buchtawill/TeslaCoilController/midi_files/README.md

IMPORTANT MIDI NOTES

The controller does not support midi events other than note on and note off. Delete all other events at the beginning of a file,
for example, "Text" or "Program change"

Tesla quad plan:

 - Imperial March
 - Spooky scary skeletons
 - Mii Channel - has 2nd part
 - Koopa Kid castle
 - tmbg famous polka
 - Hall of the mountain king
 - Star wars
 - Cantina theme
 - Daggerfall theme 008
 - ~Beach theme mario 

 - maybe virus
 - Minion march

Show order:
    Dual: Star wars opening
    Dual: Zombie nation
    Dual: Cantina
    Single Big: Yakety Sax
    Single Small: Famous Polka
    2 min pause
    Dual: Smash bros
    Dual: Mario Underground
    Dual: Mii channel (2nd part)
    3 min pause
    Dual: Spooky Scary
    1 min pause
    Dual: Imperial march
    1 min pause
    Single Big: All star
    Single Small: Tetris
    Single big: Entertainer
    3-4 min pause
    Dual Dueling Banjos
    2 min pause
    Dual Sweet home alabama, whole thing

MIDI File requirements:
 - Only on and off events - no program control change or tempo change
 - Maximum of 4 notes at any given time
 - Generally, 1 note per track
 - track 0 and 1 correspond to coil A, track 2 and 3 correspond to coil B
 - Track 0 and track 2 can have 2 notes each, as long as there are no notes on tracks 1 and 3.
 + i.e. If track 0 is playing 2 notes, one of the notes will be automatically bumped down to track 1 by software
 - Maximum frequency: Try to stay at C6 or below
 - No notes inside notes: I.E. if a note is playing on track 0, the same note cannot start again before it finishes

 Needs fixing:
 - underworld
 - dual smbtheme
 - south park theme

10/28/2025
-----------------------
Working dual coil songs:
 - zombie nation
 - Sweet home alabame
 - Star wars
 - South park
 - Smbtheme
 - Smash bros
 - Koopa kid fortress
 - nsmbw_world3
 - mario underground
 - minion march
 - mii channel
 - Dance of sugar plum fairy
 - Daggerfall theme 008
 - Cantina band
 - mario win
 - Looney
 - Imperial march
 - Dueling banjos 
 - Spooky scary skelletons
 - tetris_2coils
 - overworld 3
 - Ghostbusters 
 - Caramelldansen
 - Auld land syne*
 - all i want 2*
 - warioware
 - Rush e

Working single coil songs
-----------------------
 - star wars
 - yakety sax
 - 

Faulty dual coil songs:
 - Star trek

Not broken, needs work
 - Office theme
 - Beethoven virus 3 channels
 - beach theme mario
 - Rush E beginning too high
 - nsmbwiiKoopaKidCastle -> OK but start is iffy

Spooky Sparks 10/29/2025 set list
-------------------
220 variac: 300Vdc at 2nd notch after 210

 - DUAL:   star wars opening
 - DUAL:   Cantina band
 -     1 min
 - DUAL:   imperial march
 -     1 min
 - SINGLE: big - hall of mountain king (not onetesla)
 - SINGLE: small - all star
 - DUAL:   rush e
 - DUAL:   warioware
 -     2 min 
 - DUAL:   skeletons
 -     1 min
 - SINGLE: big - tmbg famous polka
 -     2 min
 - DUAL:   Mii channel
 - DUAL:   Dance - only first part
 - DUAL:   all i want for christmas
 -     1 min
 - DUAL:   Dueling banjos
 -     2 min 
 - DUAL:   Sweet home alabama

### starting test run at 2:30
### Ended at 2:55 with above set list
