buchtawill/TeslaCoilController/temp_volt_amp_board/firmware/display_board/README.txt

Start by getting GPIO working on !OE pin

Get SPI working to display simple stuff

Code running with multiple SPI 

Add PWM to OE pin

Add ADC acquisition
