buchtawill/TeslaCoilController/Rev2_F401RE/eagle/revb_BOM_assembly.xlsx

Value / PN | Qty | Designator | Package | Description | JLC Part No | MFR Part No
4k7 | 17 | R114, R116, R117, R121, R124, R127, R133, R135, R140, R143, R148, R200, R202, R204, R205, R207, R208 | 0603 | RESISTOR | C99782
100n | 16 | C103, C202, C203, C206, C207, C208, C213, C214, C215, C220, C222, C224, C226, C229, C230, C231 | 0603 | CAPACITOR | C1590
2k2 | 14 | R115, R128, R130, R132, R134, R136, R138, R139, R142, R144, R151, R146, R147, R149, R150 | 0603 | RESISTOR | C113303
MMBT4401(RANGE:100-300) | 10 | T1, T2, T3, T4, T5, T6, T7, T8, T9, T10 | SOT23-BEC | NPN Transistor | C2144
1u | 7 | C201, C204, C221, C223, C225, C227, C228 | 0603 | CAPACITOR | C1592
10u | 8 | C205, C209, C210, C211, C212, C216, C217, C218 | 0805 | CAPACITOR | C15850
LQH3NPN2R2MJRL | 2 | L1, L2 | IND_LQH3NPN2R2MJRL | Inductor | C9890
473521001 | 1 | J2 | SMD | Micro SD Card connector | C293569 | 473521001
STM32F401RE | 1 | IC1 | LQFP64-10X10MM | Microcontroller | C116978
TPS63001 | 1 | IC4 | 10VSON | 3.3V regulator | C28060
TPS63002 | 1 | IC5 | 10VSON | 5V regulator | C116655
