buchtawill/TeslaCoilController/Rev2_F401RE/eagle/revb_BOM.txt

Partlist exported from C:/Users/bucht/OneDrive - Worcester Polytechnic Institute (wpi.edu)/Projects/Interrupter/TeslaCoilController/Rev2_F401RE/eagle/revb.sch at 8/19/2024 11:08 PM

Qty Value               Device                                                               Package                       Parts                                                                                                                                      Description                                                                                   AVAILABILITY CHECK_PRICES                                                                      COPYRIGHT                                                DESCRIPTION                                                       MANUFACTURER                MANUFACTURER_PART_NUMBER MAXIMUM_PACKAGE_HEIGHT MF                 MFR_NAME           MP              MPN               OC_FARNELL OC_NEWARK PACKAGE                     PARTREV POPULARITY PRICE PURCHASE-URL                                                                                                                         SNAPEDA_LINK                                                                       SNAPEDA_PN          SPICEPREFIX STANDARD                     SUPPLIER  VALUE   
1                       10-XX                                                                B3F-10XX                      RST                                                                                                                                        OMRON SWITCH                                                                                                                                                                                                                                                                                                                                                                                                                                              B3F-1000          176432     36M3542                                       72                                                                                                                                                                                                                                                                                                                      
1                       CRYSTALHC49S                                                         HC49/S                        XTAL                                                                                                                                       CRYSTAL                                                                                                                                                                                                                                                                                                                                                                                                                                                                     1667008    unknown                                                                                                                                                                                                                                                                                                                                                               
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
2   LQH3NPN2R2MJRL      LQH3NPN2R2MJRL                                                       IND_LQH3NPN2R2MJRL            L1, L2                                                                                                                                     Inductor Power Chip Shielded Wirewound 33uH 20% 1MHz Ferrite 0.63A 0.948Ohm DCR 1212 T/R                                                                                                                                                                                                                                Murata                                               1.2mm                                                                                                                                           N/A                                                                                                                                                                                                                                                                              Manufacturer Recommendations                   
1   LTV-816S            SMD-PHOTOCOUPLER-5KV-LTV-816S(4P-4.6X6.5MM)                          SMD4-2.54-4.6X6.5MM           U2                                                                                                                                         306060007                                                                                                                                                                                                                                                                                                                                                                                                                                                 LTV-816S                                                                                                                                                                                                                                                                                                                                                                                   LTV-816S
1   MCP73832            MCP73831T-2ACI/OT                                                    SOT95P280X145-5N              IC2                                                                                                                                        Charge Management Controller                                                                                                                                                                                                                                                                                                                                                                                                                              MCP73831T-2ACI/OT 1332158    56K7045   SOT-5                                                                                                                                                                                                                                                                                                                                     Microchip         
1   MEM2051-0019500A    MEM2051-00-195-00-A_REVD1MEM2051-00-195-00-A_GCT_MEM2051-00-195-00-A GCT_MEM2051-00-195-00-A_REVD1 J2                                                                                                                                                                                                                                                                                                                                                                                                                                                                 GCT                                                  2.05 mm                                                                                                                                         D1                                                                                                                                                                                                                                               MEM2051-00-195-00-A             Manufacturer Recommendations                   
10  MMBTA06-7-F         BCV72SMD                                                             SOT23-BEC                     T1, T2, T3, T4, T5, T6, T7, T8, T9, T10                                                                                                    NPN Transistor                                                                                                                                                                                                                                                                                                                                                                                                                                                                                                                       0                                                                                                                                                                                                                                                                                                                       
4   MOUNT-HOLE4.5       MOUNT-HOLE4.5                                                        4,5                           H1, H2, H3, H4                                                                                                                             MOUNTING HOLE with drill center marker                                                                                                                                                                                                                                                                                                                                                                                                                                                                                               0                                                                                                                                                                                                                                                                                                                       
1   SI7615              SI7611DN-T1-GE3                                                      VISHAY_SIS468DN-T1-GE3        Q1                                                                                                                                         P-Channel 40 V 0.025 Ohm 39 W Surface Mount Power Mosfet - PowerPAK-1212-8 Check availability In Stock     https://www.snapeda.com/parts/SI7611DN-T1-GE3/Vishay+Siliconix/view-part/?ref=eda                                                           MOSFET P-CH 40V 18A 1212-8 | Siliconix / Vishay SI7611DN-T1-GE3                                                                              Vishay                                SI7611DN-T1-GE3                                        PowerPAK®-1212 Vishay                          None  https://www.snapeda.com/api/url_track_click_mouser/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 https://www.snapeda.com/parts/SI7611DN-T1-GE3/Vishay+Siliconix/view-part/?ref=snap                                                                                
1   STM32F401RE         STM32F401RET6                                                        LQFP64-10X10MM                IC1                                                                                                                                                                                                                                                                                                                                     Copyright (C) 2024 Ultra Librarian. All rights reserved.                                                                                               STM32F401RET6                                                      STMicroelectronics                                                                                                                                                                                                                                                                                                                                                                                                                    
1   TPS63001            TPS63001DRCR                                                         VREG_V62/16624-01YE           IC4                                                                                                                                                                                                                                                                                                                                                                                                                                                                                                                                                                                                                                                                                                                                                                                                                                                                                                                                                                                                     
1   TPS63002            TPS63001DRCR                                                         VREG_V62/16624-01YE           IC5                                                                                                                                                                                                                                                                                                                                                                                                                                                                                                                                                                                                                                                                                                                                                                                                                                                                                                                                                                                                     
1   USB4105-GF-A        USB4105-GF-A                                                         GCT_USB4105-GF-A              J1                                                                                                                                                                                                                                                                                                                                                                                                                                                                 Global Connector Technology                          3.31mm                                                                                                                                          B3                                                                                                                                                                                                                                                                               Manufacturer Recommendations                   
1   USBLC6-2SC6         USBLC6-2SC6                                                          SOT95P280X145-6N              D100                                                                                                                                       Check availability  Check availability                                                        In Stock                                                                                                                                                 17V Clamp 5A (8/20µs) Ipp Tvs Diode Surface Mount SOT-23-6                                                                                   STMicroelectronics                    USBLC6-2SC6                                            SOT-23-6 STMicroelectronics                    None  https://pricing.snapeda.com/search/part/USBLC6-2SC6/?ref=eda
