buchtawill/TeslaCoilController/(list of files, cad)

Other CAD files:
Rev2_F401RE/fusion360/interrupter_rev_3.f3d
