buchtawill/TeslaCoilController/Rev2_F401RE/eagle/revb_schematic.pdf

# 4k7+3V3 GND

PA0 14 | PA1 15 | PA2 16 | PA3 17 | PA4 20 | PA5 21 | PA6 22 | PA7 23 | PA8 41 | PA9 42 | PA10 43 | PA11 44 | PA12 45 | PA13 46 | PA14 49 | PA15 50 | PB0 26 | PB1 27 | PB2 28 | PB3 55 | PB4 56 | PB5 57 | PB6 58 | PB7 59 | PB8 61 | PB9 62 | PB10 29 | PB12 33 | PB13 34 | PB14 35 | PB15 36

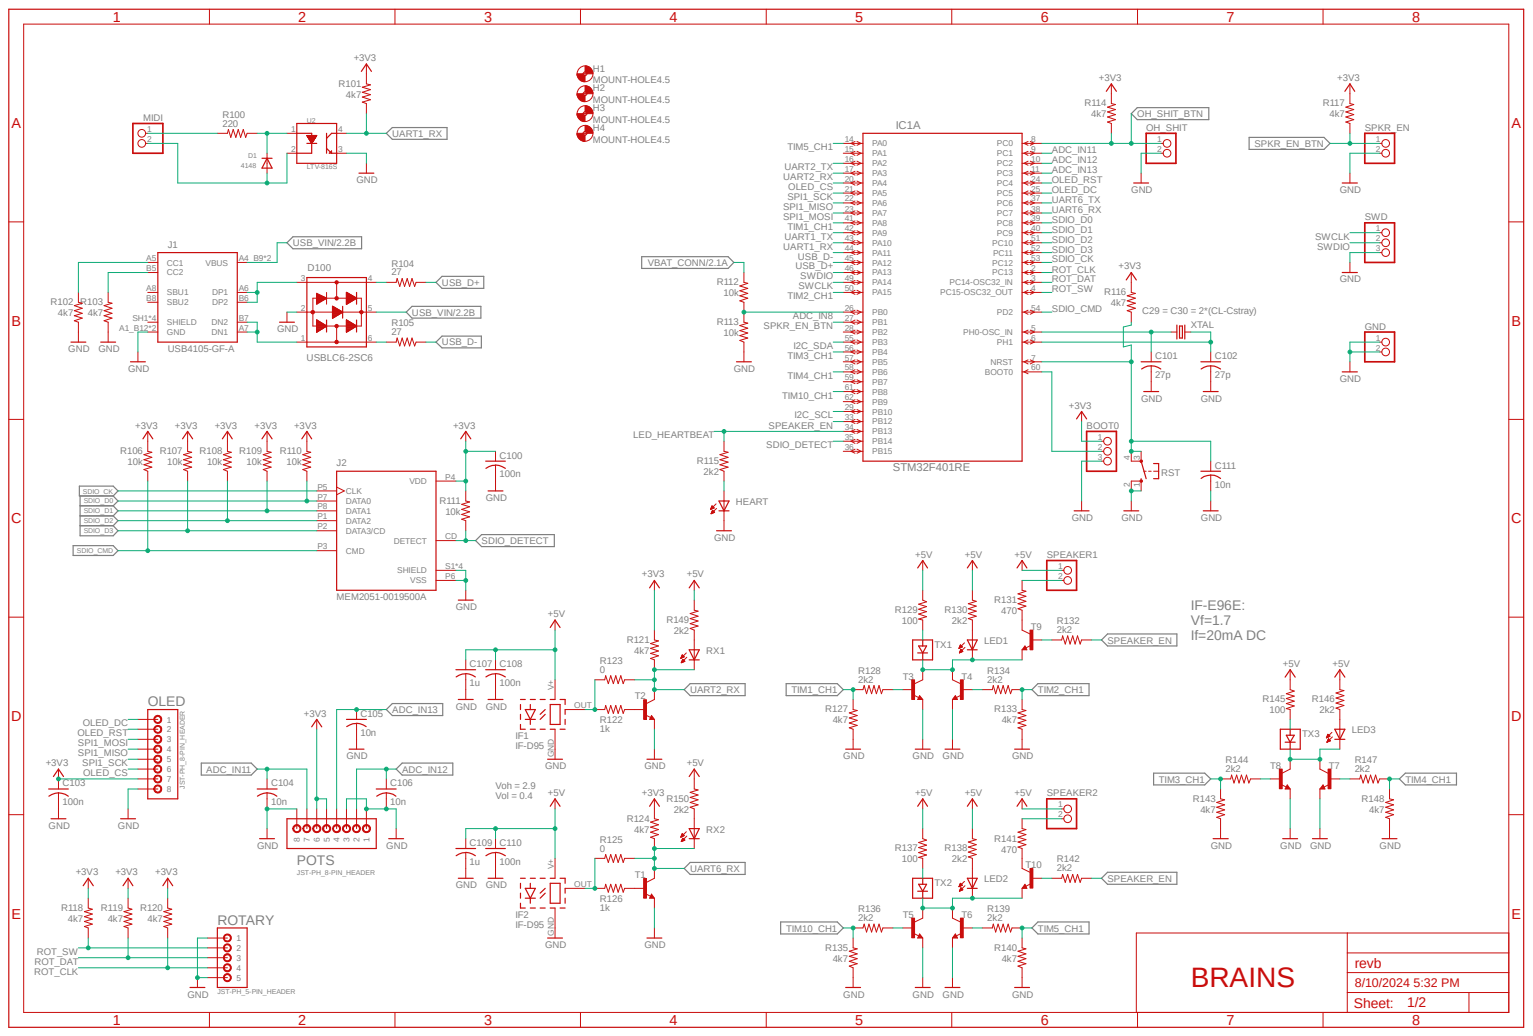
[picture p3: page 1]

BRAINS

Sheet: 1/2

# +3V3 +5VGND GND

# 10u GND GND

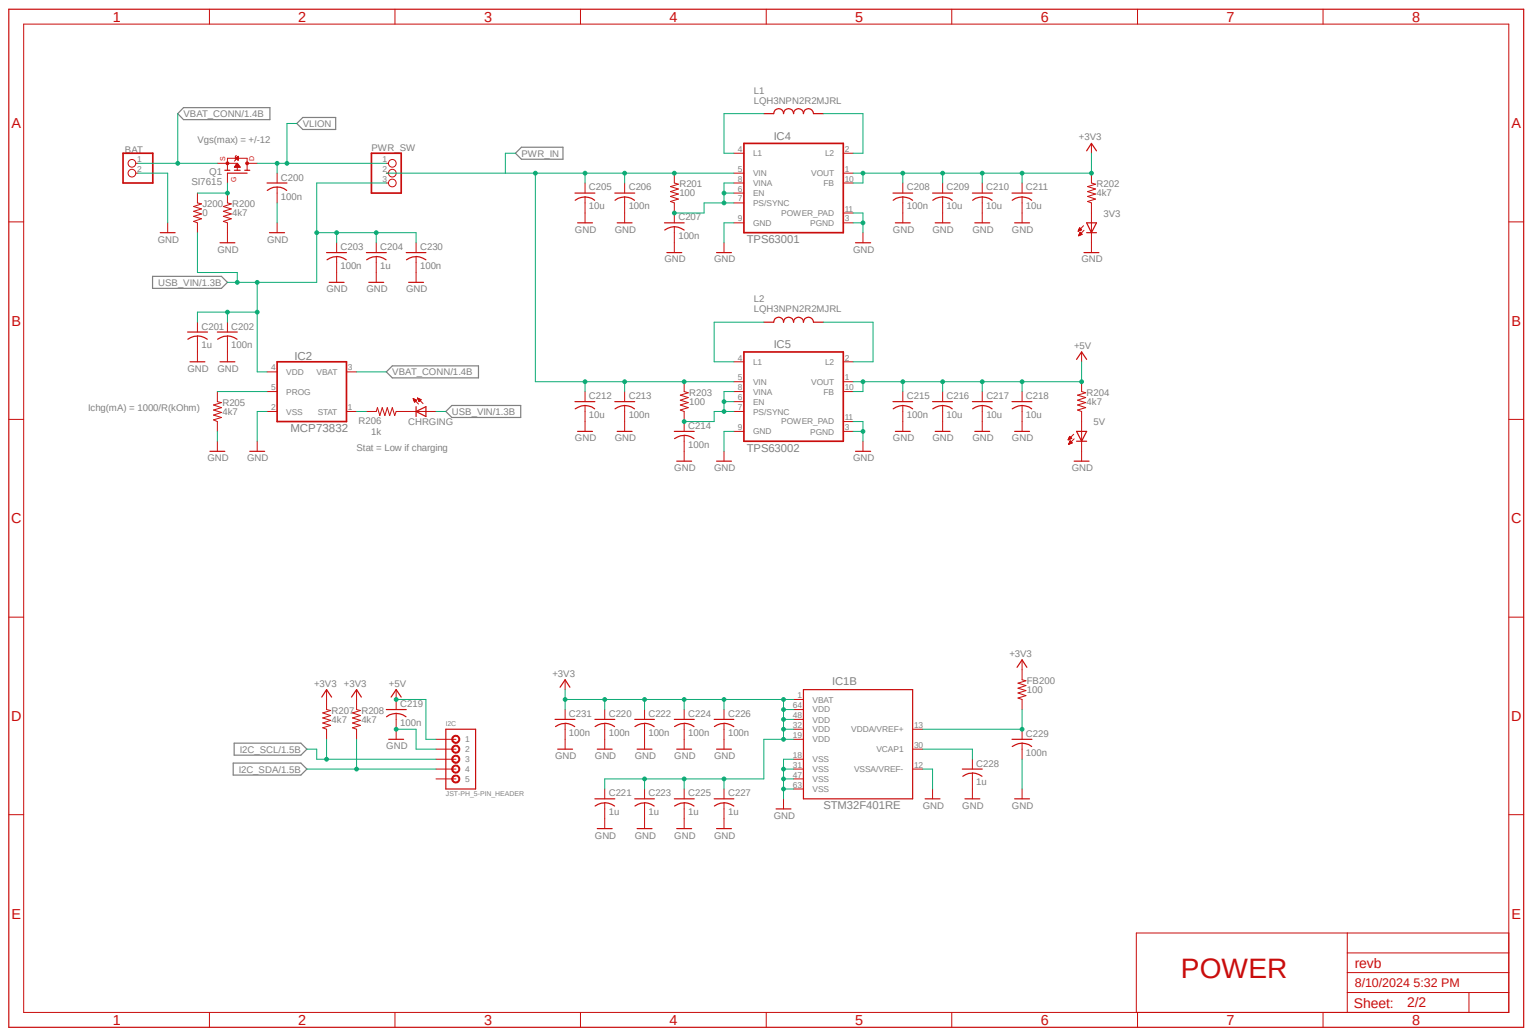
[picture p4: page 2]

Stat = Low if charging

POWER

Sheet: 2/2
