buchtawill/TeslaCoilController/temp_volt_amp_board/Temp sensor diagram.pdf

54
Vbus | 3.30LDOADP22 | 12H 3.3viso-5VB maxs.ssb

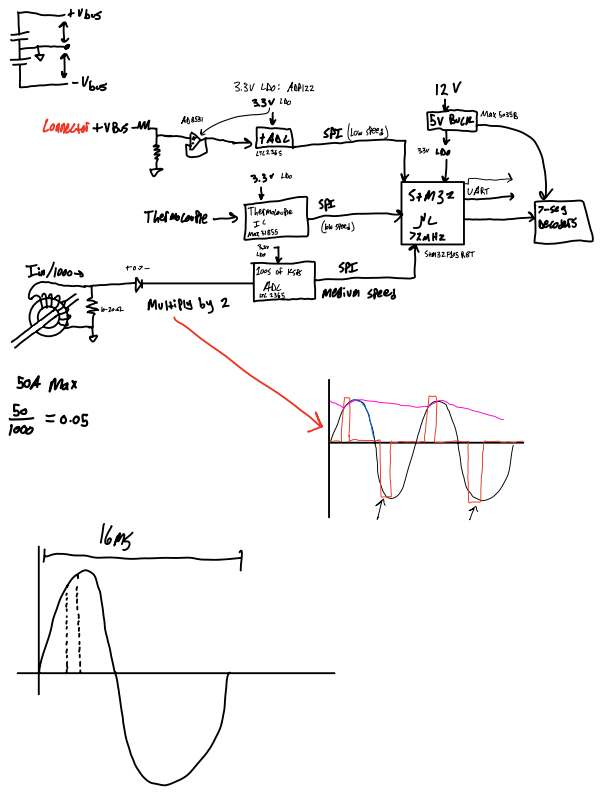
[picture p5: page 1]
50AMax as; yWr; Niiii U

www.syii iEittiiif Thermocouples É fs

Ñ

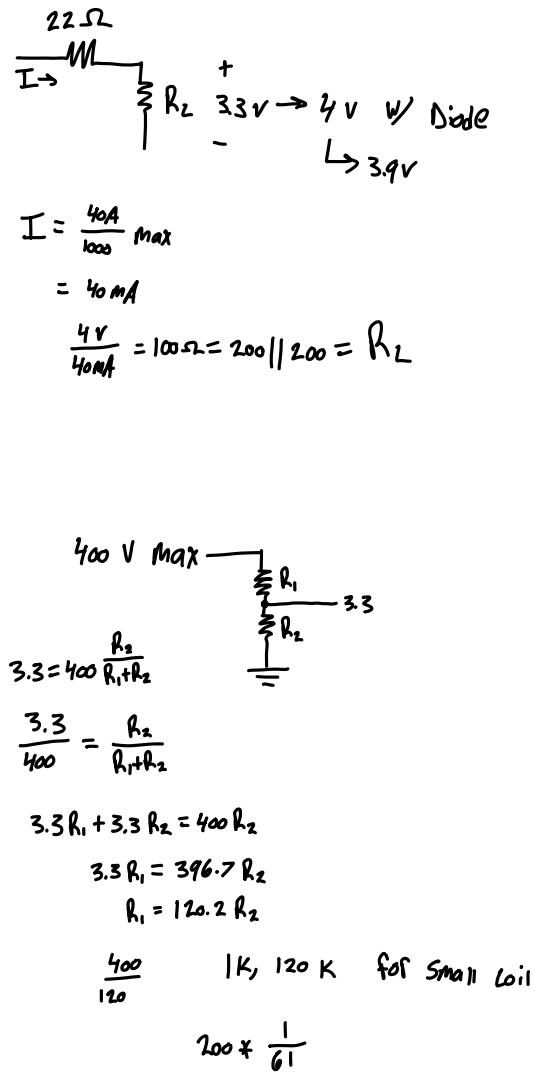
[picture p6: page 2]
R I.su 4v w Diode; max; 4000Max; 3.3 400RPFR; T TEA; 33R 3.3Rz ⁴⁰⁰Rz 3.3R 396.7R R 120.2Rz; 1k 120K forsmallcoil
