buchtawill/TeslaCoilController/L151_interrupter/rev1.pdf

+3V3 GND ¹⁰⁰n | 100n | 100n USB6B1RL GND | GND
R9 | R25 | R28 C²⁸ | C²⁹ | C³⁰ VCC_2 1

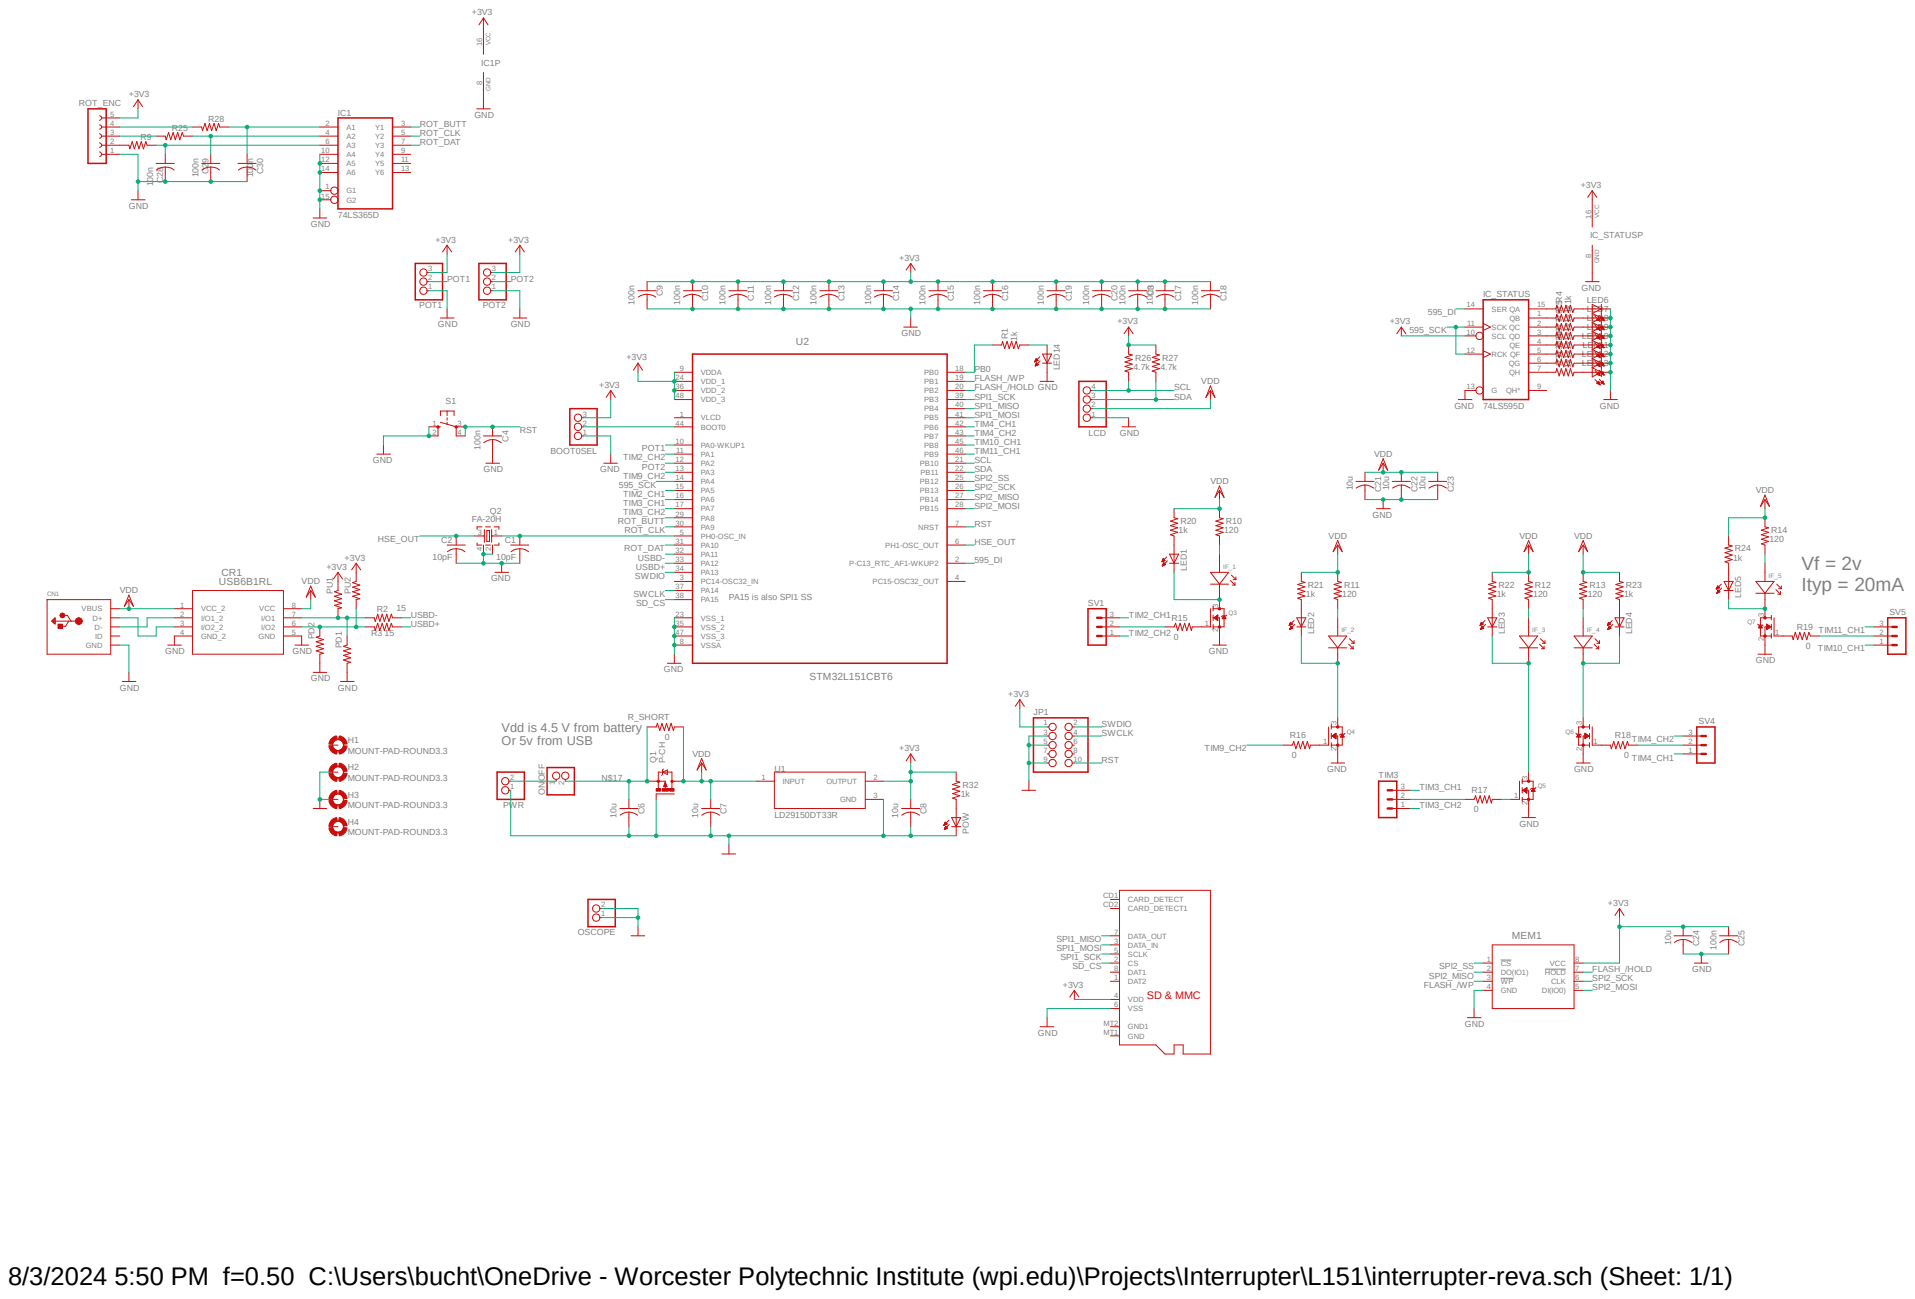
[picture p7: page 1]

Vdd is 4.5 V from battery Or 5v from USB

8/3/2024 5:50 PM f=0.50 C:\Users\bucht\OneDrive - Worcester Polytechnic Institute (wpi.edu)\Projects\Interrupter\L151\interrupter-reva.sch (Sheet: 1/1)
