buchtawill/TeslaCoilController/Rev2_F401RE/eagle/revc_sch.pdf

# 4k7+3V3 GND

# 2N3906 +3V3 GND

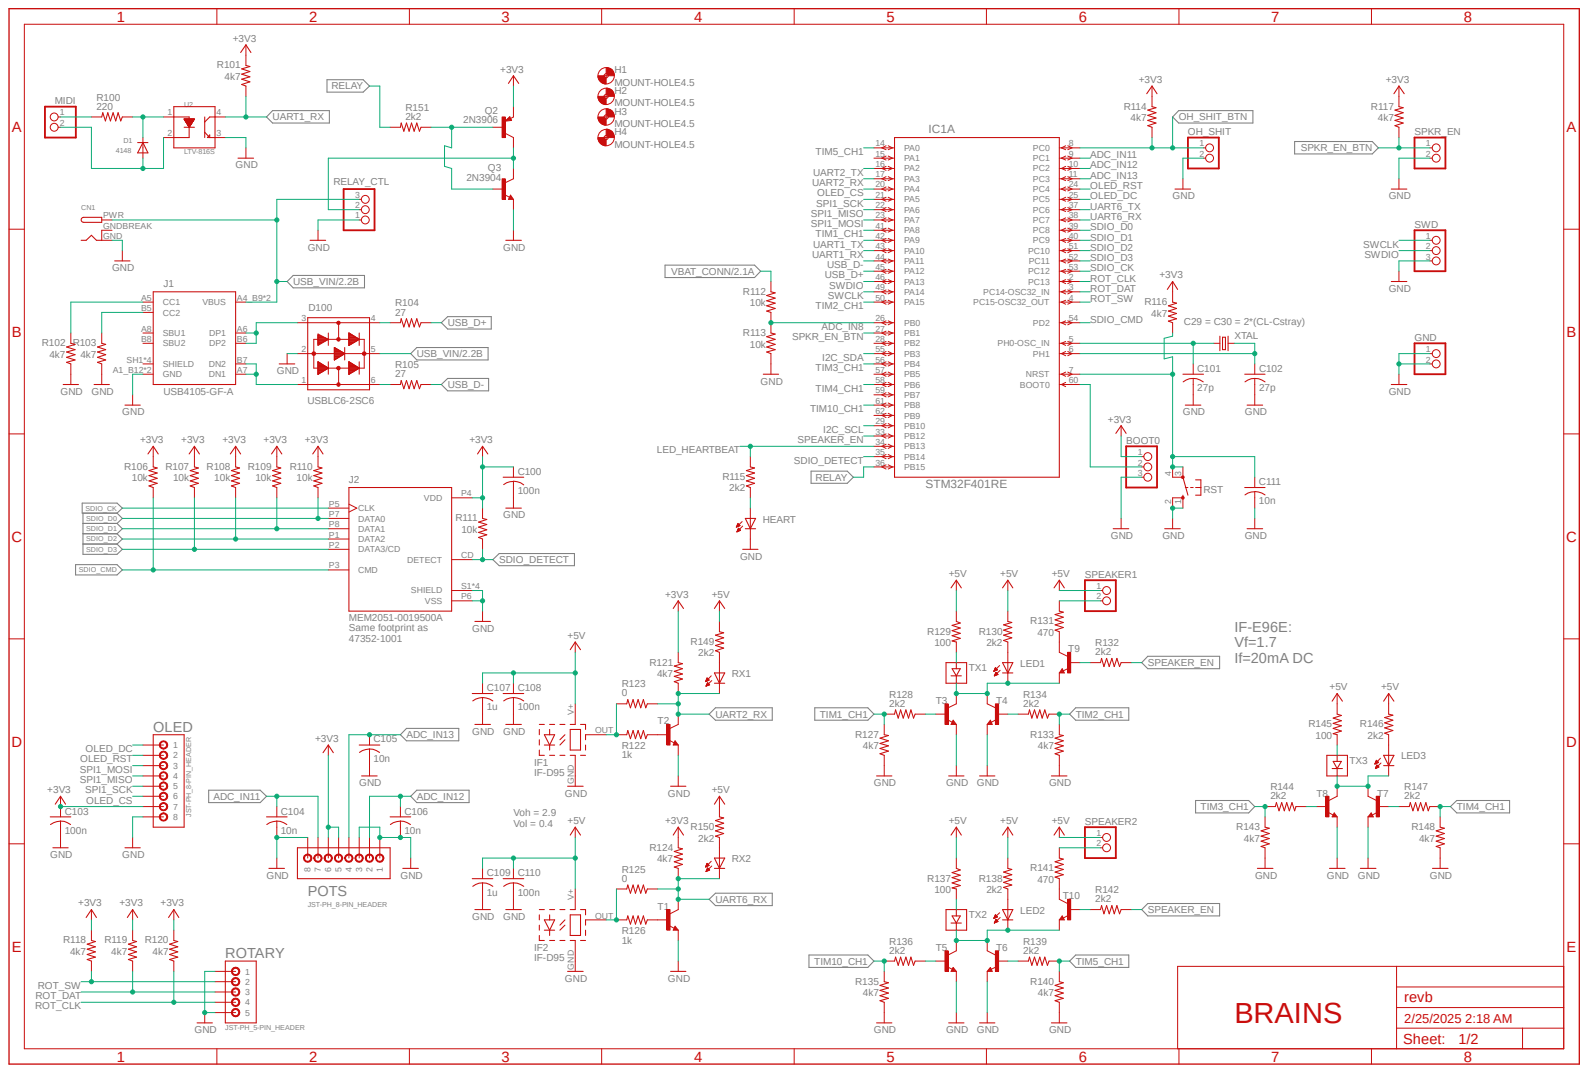
[picture p8: page 1]

# +3V3 +5V GND GND

A

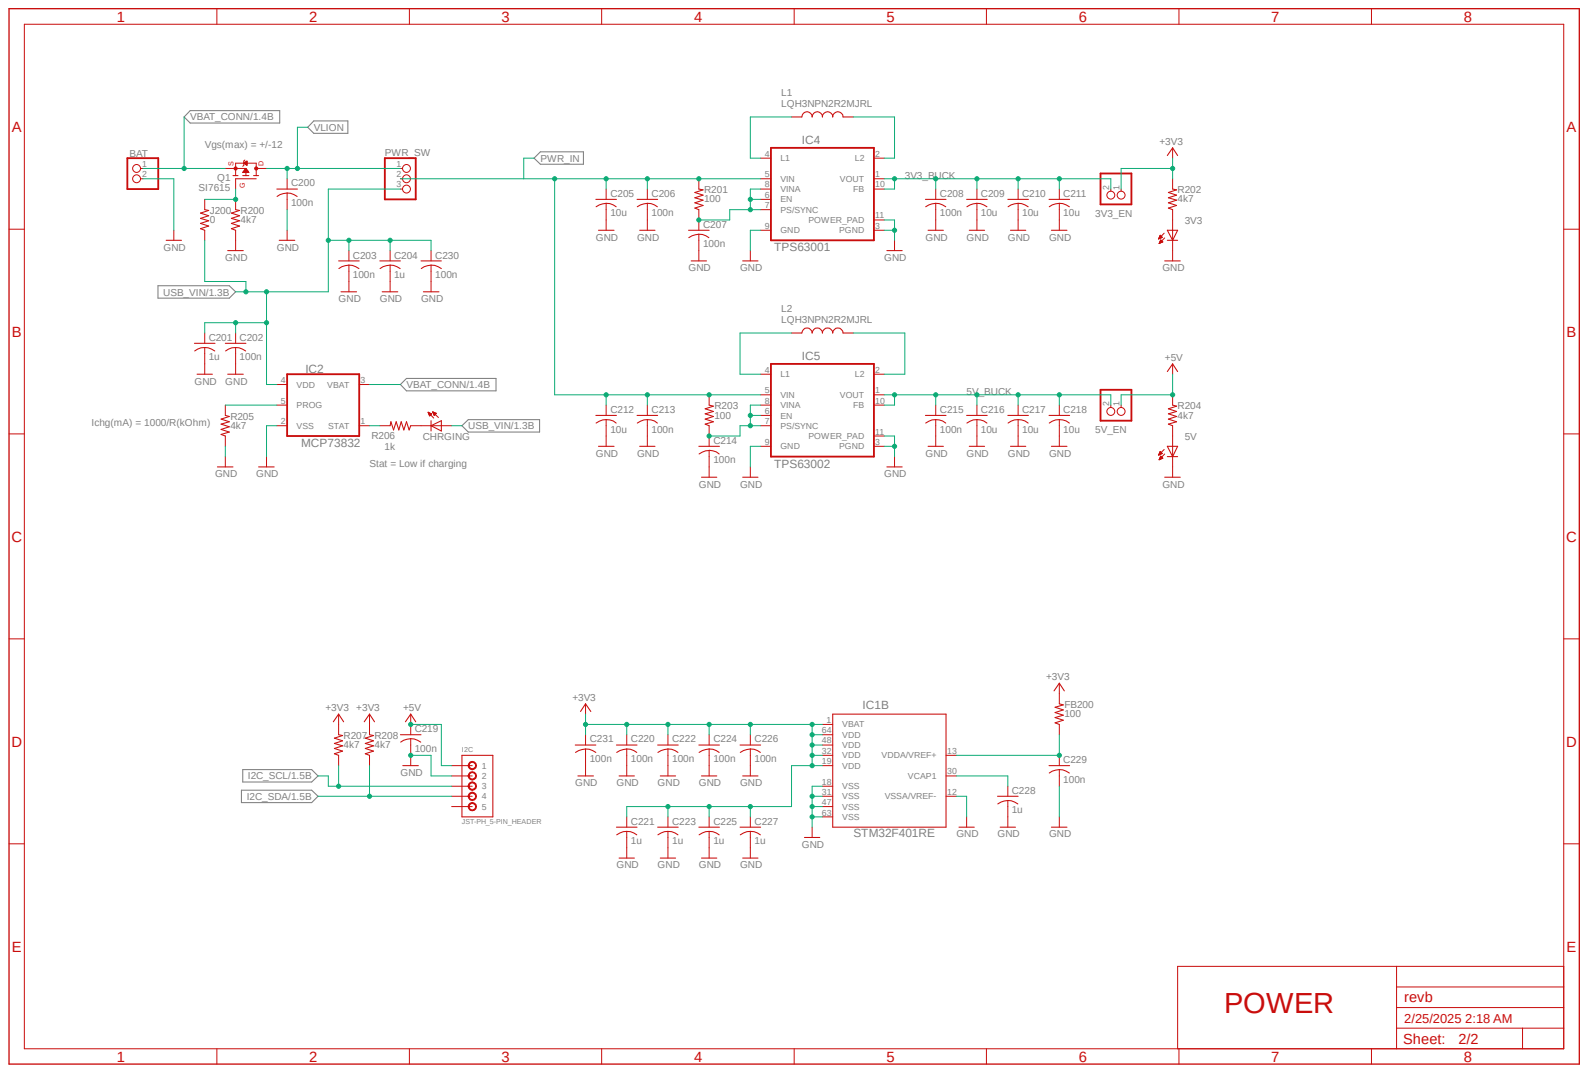
[picture p9: page 2]

Stat = Low if charging

POWER

Sheet: 2/2
