buchtawill/TeslaCoilController/temp_volt_amp_board/CAD/rev1_eagle/sensor_board_sch.pdf

A

A

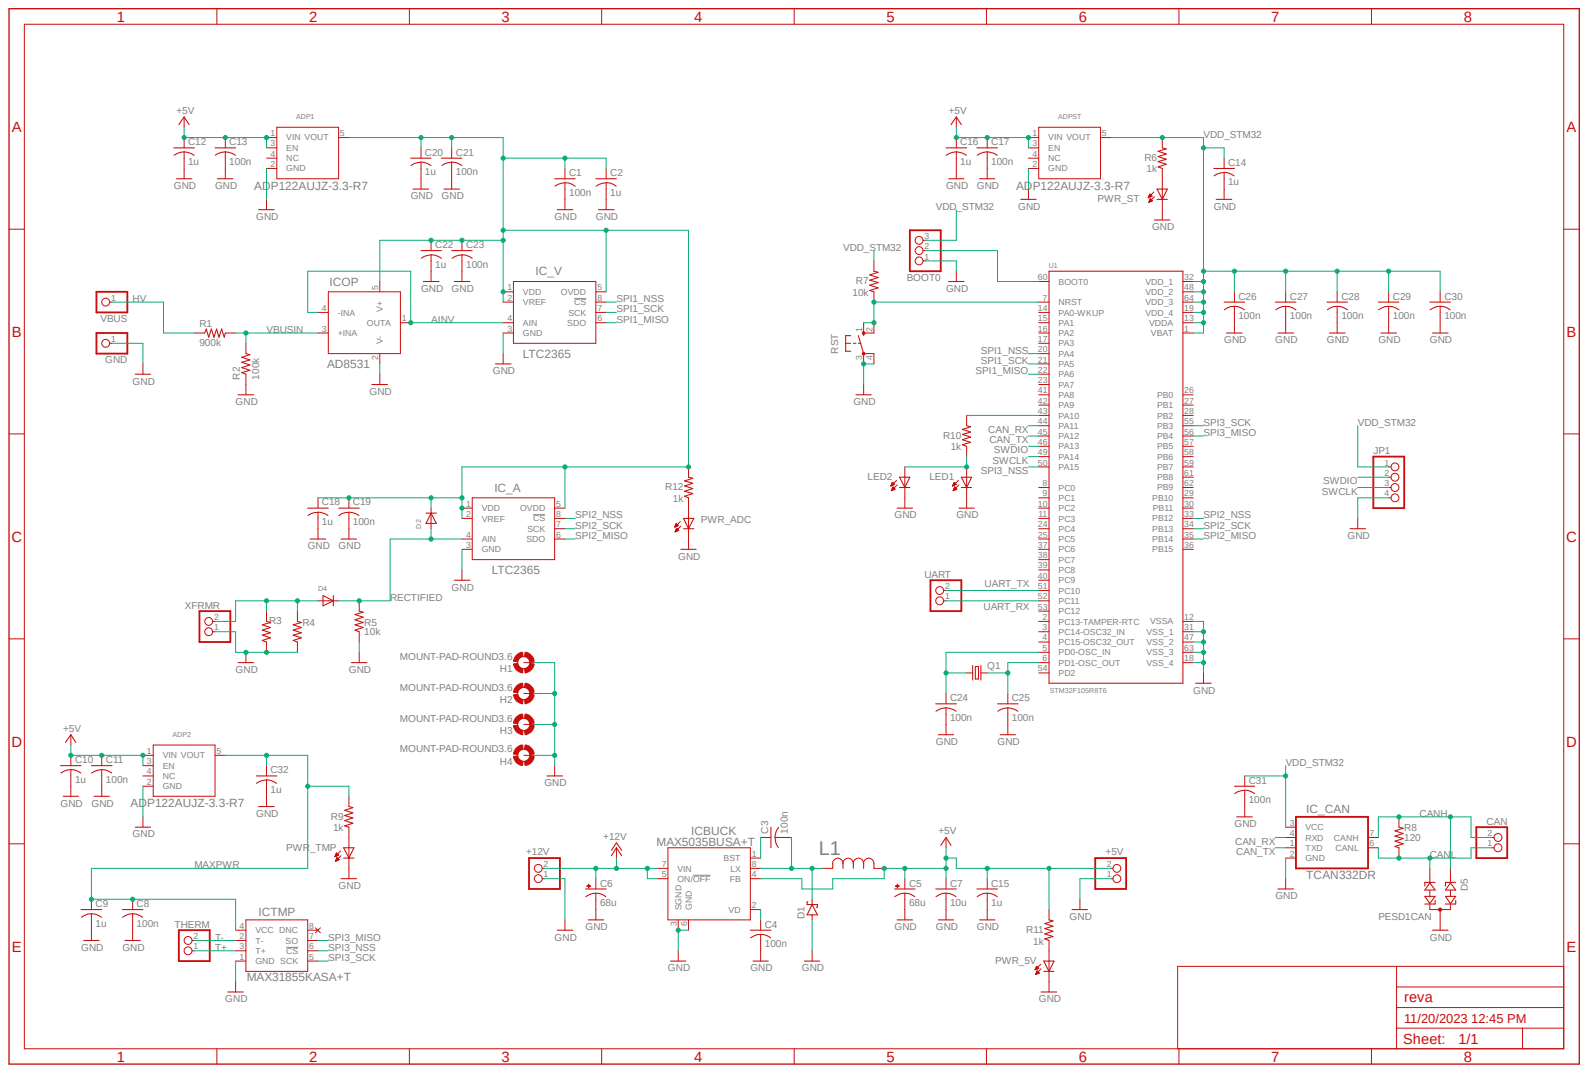
[picture p10: page 1]

3 FB 4 ON/OFF 5 GND
