buchtawill/TeslaCoilController/temp_volt_amp_board/CAD/rev1_eagle/main_board.brd

## EAGLE design temp_volt_amp_board/CAD/rev1_eagle/main_board.brd (2024-10-24)

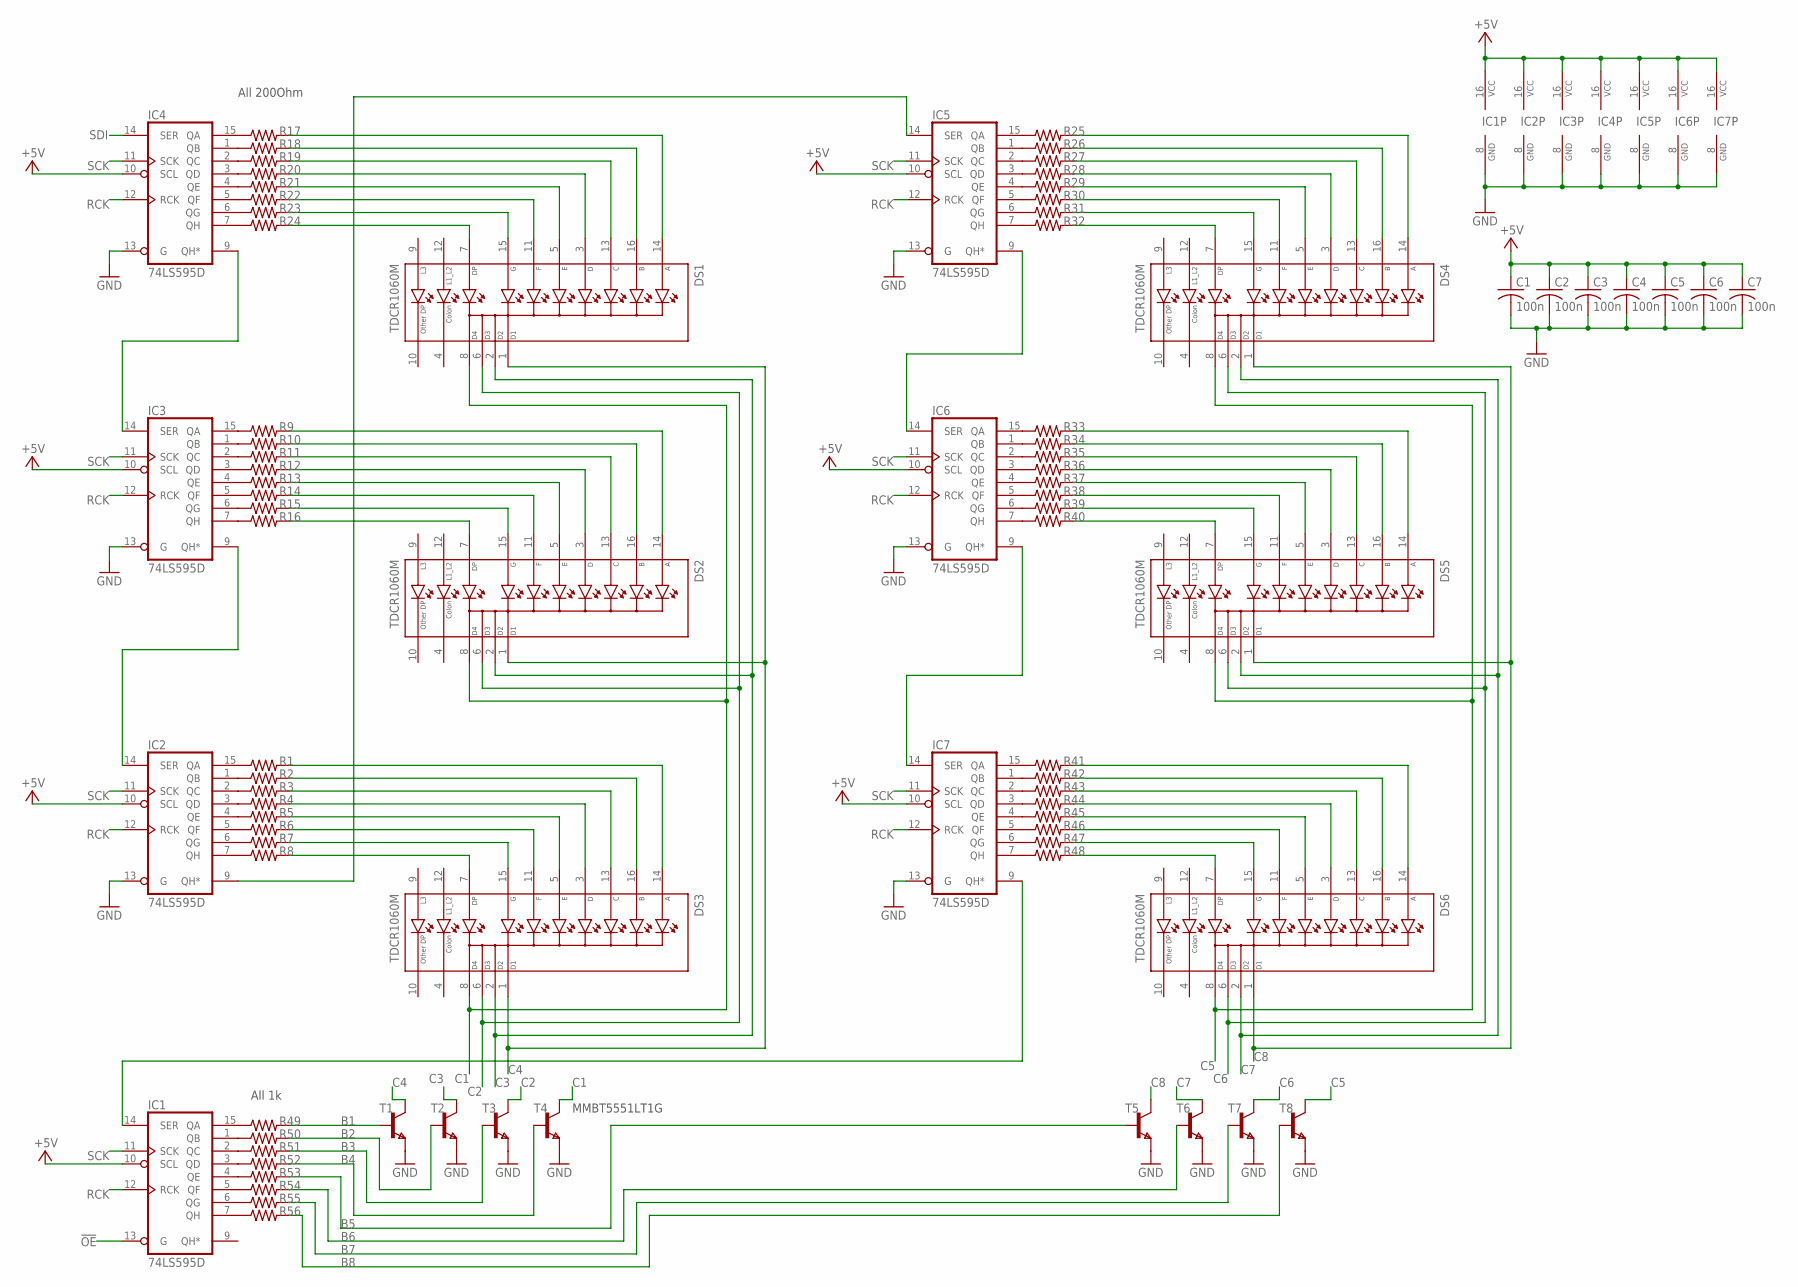
[picture p11: schematic main_board.sch, sheet 1]

Parts:
C1, C2, C3, C4, C5, C6, C7: 100n; C0603
DS1, DS2, DS3, DS4, DS5, DS6: TDCR1060M; DISPLAY_TDCR1060M
IC1, IC2, IC3, IC4, IC5, IC6, IC7: 74LS595D; SO16
R1, R2, R3, R4, R5, R6, R7, R8, R9, R10, R11, R12, R13, R14, R15, R16, R17, R18, R19, R20, R21, R22, R23, R24, R25, R26, R27, R28, R29, R30, R31, R32, R33, R34, R35, R36, R37, R38, R39, R40, R41, R42, R43, R44, R45, R46, R47, R48, R49, R50, R51, R52, R53, R54, R55, R56: R-US_R0603; R0603
T1, T2, T3, T4, T5, T6, T7, T8: NPNSOT23; SOT-23

Connections:
!OE: IC1.13 (G); also elsewhere on the board
+5V: C1.1, C2.1, C3.1, C4.1, C5.1, C6.1, C7.1, IC1.10 (SCL), IC1.16 (VCC), IC2.10 (SCL), IC2.16 (VCC), IC3.10 (SCL), IC3.16 (VCC), IC4.10 (SCL), IC4.16 (VCC), IC5.10 (SCL), IC5.16 (VCC), IC6.10 (SCL), IC6.16 (VCC), IC7.10 (SCL), IC7.16 (VCC); also elsewhere on the board
B1: R49.2, T1.3 (B)
B2: R50.2, T2.3 (B)
B3: R51.2, T3.3 (B)
B4: R52.2, T4.3 (B)
B5: R53.2, T5.3 (B)
B6: R54.2, T6.3 (B)
B7: R55.2, T7.3 (B)
B8: R56.2, T8.3 (B)
C1: DS1.8 (D4), DS2.8 (D4), DS3.8 (D4), T4.1 (C)
C2: DS1.6 (D3), DS2.6 (D3), DS3.6 (D3), T3.1 (C)
C3: DS1.2 (D2), DS2.2 (D2), DS3.2 (D2), T2.1 (C)
C4: DS1.1 (D1), DS2.1 (D1), DS3.1 (D1), T1.1 (C)
C5: DS4.8 (D4), DS5.8 (D4), DS6.8 (D4), T8.1 (C)
C6: DS4.6 (D3), DS5.6 (D3), DS6.6 (D3), T7.1 (C)
C7: DS4.2 (D2), DS5.2 (D2), DS6.2 (D2), T6.1 (C)
C8: DS4.1 (D1), DS5.1 (D1), DS6.1 (D1), T5.1 (C)
GND: C1.2, C2.2, C3.2, C4.2, C5.2, C6.2, C7.2, IC1.8 (GND), IC2.8 (GND), IC2.13 (G), IC3.8 (GND), IC3.13 (G), IC4.8 (GND), IC4.13 (G), IC5.8 (GND), IC5.13 (G), IC6.8 (GND), IC6.13 (G), IC7.8 (GND), IC7.13 (G), T1.2 (E), T2.2 (E), T3.2 (E), T4.2 (E), T5.2 (E), T6.2 (E), T7.2 (E), T8.2 (E); also elsewhere on the board
unnamed: IC2.15 (QA), R1.1
unnamed: IC2.1 (QB), R2.1
unnamed: IC2.2 (QC), R3.1
unnamed: IC2.3 (QD), R4.1
unnamed: IC2.4 (QE), R5.1
unnamed: IC2.5 (QF), R6.1
unnamed: IC2.6 (QG), R7.1
unnamed: IC2.7 (QH), R8.1
unnamed: IC3.15 (QA), R9.1
unnamed: IC3.1 (QB), R10.1
unnamed: IC3.2 (QC), R11.1
unnamed: IC3.3 (QD), R12.1
unnamed: IC3.4 (QE), R13.1
unnamed: IC3.5 (QF), R14.1
unnamed: IC3.6 (QG), R15.1
unnamed: IC3.7 (QH), R16.1
unnamed: DS2.7 (DP), R16.2
unnamed: DS2.15 (G), R15.2
unnamed: DS2.11 (F), R14.2
unnamed: DS2.5 (E), R13.2
unnamed: DS2.3 (D), R12.2
unnamed: DS2.13 (C), R11.2
unnamed: DS2.16 (B), R10.2
unnamed: DS2.14 (A), R9.2
unnamed: DS3.7 (DP), R8.2
unnamed: DS3.15 (G), R7.2
unnamed: DS3.11 (F), R6.2
unnamed: DS3.5 (E), R5.2
unnamed: DS3.3 (D), R4.2
unnamed: DS3.13 (C), R3.2
unnamed: DS3.16 (B), R2.2
unnamed: DS3.14 (A), R1.2
unnamed: IC4.15 (QA), R17.1
unnamed: IC4.1 (QB), R18.1
unnamed: IC4.2 (QC), R19.1
unnamed: IC4.3 (QD), R20.1
unnamed: IC4.4 (QE), R21.1
unnamed: IC4.5 (QF), R22.1
unnamed: IC4.6 (QG), R23.1
unnamed: IC4.7 (QH), R24.1
unnamed: DS1.7 (DP), R24.2
unnamed: DS1.15 (G), R23.2
unnamed: DS1.11 (F), R22.2
unnamed: DS1.5 (E), R21.2
unnamed: DS1.3 (D), R20.2
unnamed: DS1.13 (C), R19.2
unnamed: DS1.16 (B), R18.2
unnamed: DS1.14 (A), R17.2
unnamed: IC5.15 (QA), R25.1
unnamed: IC5.1 (QB), R26.1
unnamed: IC5.2 (QC), R27.1
unnamed: IC5.3 (QD), R28.1
unnamed: IC5.4 (QE), R29.1
unnamed: IC5.5 (QF), R30.1
unnamed: IC5.6 (QG), R31.1
unnamed: IC5.7 (QH), R32.1
unnamed: DS4.7 (DP), R32.2
unnamed: DS4.15 (G), R31.2
unnamed: DS4.11 (F), R30.2
unnamed: DS4.5 (E), R29.2
unnamed: DS4.3 (D), R28.2
unnamed: DS4.13 (C), R27.2
unnamed: DS4.16 (B), R26.2
unnamed: DS4.14 (A), R25.2
unnamed: IC6.15 (QA), R33.1
unnamed: IC6.1 (QB), R34.1
unnamed: IC6.2 (QC), R35.1
unnamed: IC6.3 (QD), R36.1
unnamed: IC6.4 (QE), R37.1
unnamed: IC6.5 (QF), R38.1
unnamed: IC6.6 (QG), R39.1
unnamed: IC6.7 (QH), R40.1
unnamed: DS5.7 (DP), R40.2
unnamed: DS5.15 (G), R39.2
unnamed: DS5.11 (F), R38.2
unnamed: DS5.5 (E), R37.2
unnamed: DS5.3 (D), R36.2
unnamed: DS5.13 (C), R35.2
unnamed: DS5.16 (B), R34.2
unnamed: DS5.14 (A), R33.2
unnamed: IC7.15 (QA), R41.1
unnamed: IC7.1 (QB), R42.1
unnamed: IC7.2 (QC), R43.1
unnamed: IC7.3 (QD), R44.1
unnamed: IC7.4 (QE), R45.1
unnamed: IC7.5 (QF), R46.1
unnamed: IC7.6 (QG), R47.1
unnamed: IC7.7 (QH), R48.1
unnamed: DS6.7 (DP), R48.2
unnamed: DS6.15 (G), R47.2
unnamed: DS6.11 (F), R46.2
unnamed: DS6.5 (E), R45.2
unnamed: DS6.3 (D), R44.2
unnamed: DS6.13 (C), R43.2
unnamed: DS6.16 (B), R42.2
unnamed: DS6.14 (A), R41.2
unnamed: IC2.9 (QH*), IC5.14 (SER)
unnamed: IC5.9 (QH*), IC6.14 (SER)
unnamed: IC6.9 (QH*), IC7.14 (SER)
unnamed: IC3.14 (SER), IC4.9 (QH*)
unnamed: IC2.14 (SER), IC3.9 (QH*)
unnamed: IC1.14 (SER), IC7.9 (QH*)
unnamed: IC1.15 (QA), R49.1
unnamed: IC1.1 (QB), R50.1
unnamed: IC1.2 (QC), R51.1
unnamed: IC1.3 (QD), R52.1
unnamed: IC1.4 (QE), R53.1
unnamed: IC1.5 (QF), R54.1
unnamed: IC1.6 (QG), R55.1
unnamed: IC1.7 (QH), R56.1
RCK: IC1.12 (RCK), IC2.12 (RCK), IC3.12 (RCK), IC4.12 (RCK), IC5.12 (RCK), IC6.12 (RCK), IC7.12 (RCK); also elsewhere on the board
SCK: IC1.11 (SCK), IC2.11 (SCK), IC3.11 (SCK), IC4.11 (SCK), IC5.11 (SCK), IC6.11 (SCK), IC7.11 (SCK); also elsewhere on the board
SDI: IC4.14 (SER); also elsewhere on the board

Notes on the sheet:
MMBT5551LT1G
All 200Ohm
All 1k

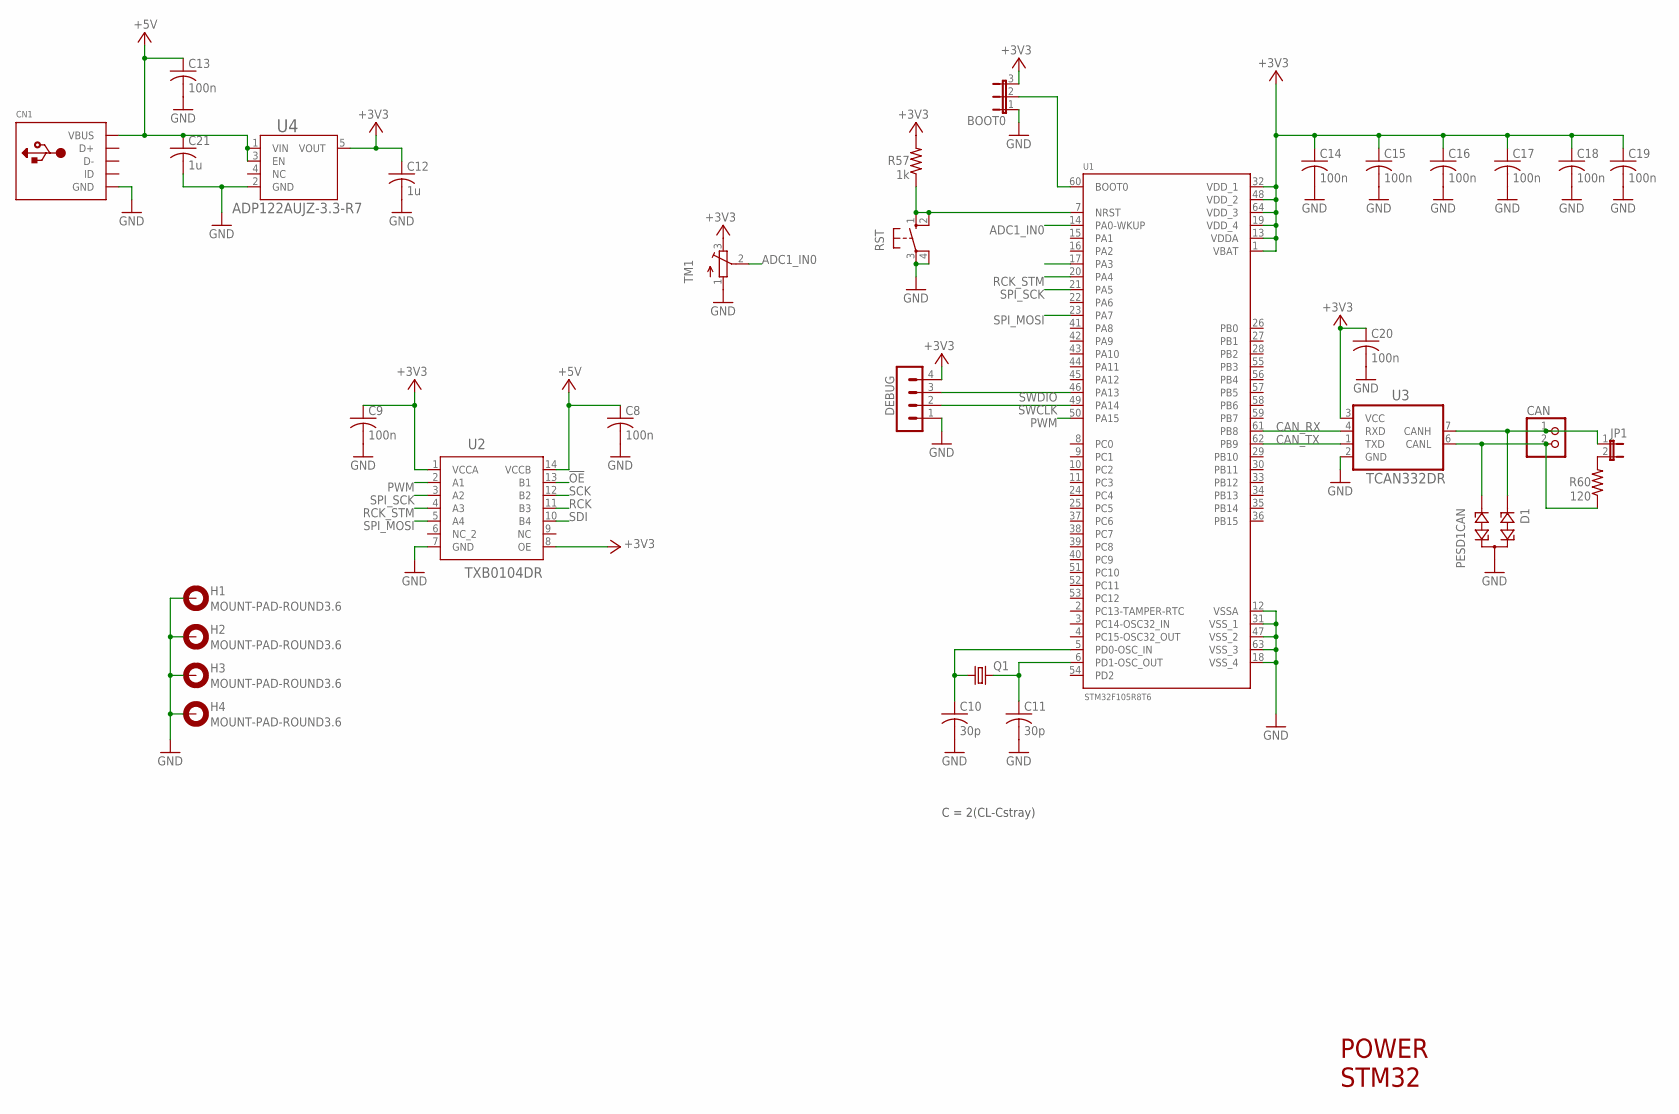
[picture p12: schematic main_board.sch, sheet 2]

Parts:
BOOT0: JP2E; JP2
C8, C9, C13, C14, C15, C16, C17, C18, C19, C20: 100n; C0603
C10, C11: 30p; C0603
C12, C21: 1u; C0603
CAN: PINHD-1X2; 1X02
CN1: USBMINIB; USB-MINIB
D1: PESD1CAN; SOT23
DEBUG: MA04-1
H1, H2, H3, H4: MOUNT-PAD-ROUND3.6; 3,6-PAD
JP1: JP1E; JP1
Q1: CRYSTALHC49S; HC49/S
R57: 1k; R0805
R60: 120; R0805
RST: 10-XX; B3F-10XX
TM1: TRIMPOT3386; TRIM-3386
U1: STM32F105R8T6; QFP50P1200X1200X160-64N
U2: TXB0104DR; D14
U3: TCAN332DR; SOIC127P599X175-8N
U4: ADP122AUJZ-3.3-R7; SOT95P280X100-5N

Connections:
!OE: U2.13 (B1); also elsewhere on the board
+3V3: BOOT0.3, C9.1, C12.1, C14.1, C15.1, C16.1, C17.1, C18.1, C19.1, C20.1, DEBUG.4, R57.2, TM1.3 (E), U1.1 (VBAT), U1.13 (VDDA), U1.19 (VDD_4), U1.32 (VDD_1), U1.48 (VDD_2), U1.64 (VDD_3), U2.1 (VCCA), U2.8 (OE), U3.3 (VCC), U4.5 (VOUT)
+5V: C8.1, C13.1, C21.1, CN1.VBUS, U2.14 (VCCB), U4.1 (VIN), U4.3 (EN); also elsewhere on the board
ADC1_IN0: TM1.2 (S), U1.14 (PA0-WKUP)
CAN_RX: U1.61 (PB8), U3.4 (RXD)
CAN_TX: U1.62 (PB9), U3.1 (TXD)
GND: BOOT0.1, C8.2, C9.2, C10.2, C11.2, C12.2, C13.2, C14.2, C15.2, C16.2, C17.2, C18.2, C19.2, C20.2, C21.2, CN1.GND, D1.3, DEBUG.1, H1.B3,6, H2.B3,6, H3.B3,6, H4.B3,6, RST.3, RST.4 (P1), TM1.1 (A), U1.12 (VSSA), U1.18 (VSS_4), U1.31 (VSS_1), U1.47 (VSS_2), U1.63 (VSS_3), U2.7 (GND), U3.2 (GND), U4.2 (GND); also elsewhere on the board
unnamed: CAN.1, D1.1, JP1.1, U3.7 (CANH)
unnamed: CAN.2, D1.2, R60.1, U3.6 (CANL)
unnamed: JP1.2, R60.2
unnamed: R57.1, RST.1 (S), RST.2 (S1), U1.7 (NRST)
unnamed: C10.1, Q1.1, U1.5 (PD0-OSC_IN)
unnamed: C11.1, Q1.2, U1.6 (PD1-OSC_OUT)
unnamed: BOOT0.2, U1.60 (BOOT0)
PWM: U1.50 (PA15), U2.2 (A1)
RCK: U2.11 (B3); also elsewhere on the board
RCK_STM: U1.20 (PA4), U2.4 (A3)
SCK: U2.12 (B2); also elsewhere on the board
SDI: U2.10 (B4); also elsewhere on the board
SPI_MOSI: U1.23 (PA7), U2.5 (A4)
SPI_SCK: U1.21 (PA5), U2.3 (A2)
SWCLK: DEBUG.2, U1.49 (PA14)
SWDIO: DEBUG.3, U1.46 (PA13)

Notes on the sheet:
POWER STM32
C = 2(CL-Cstray)

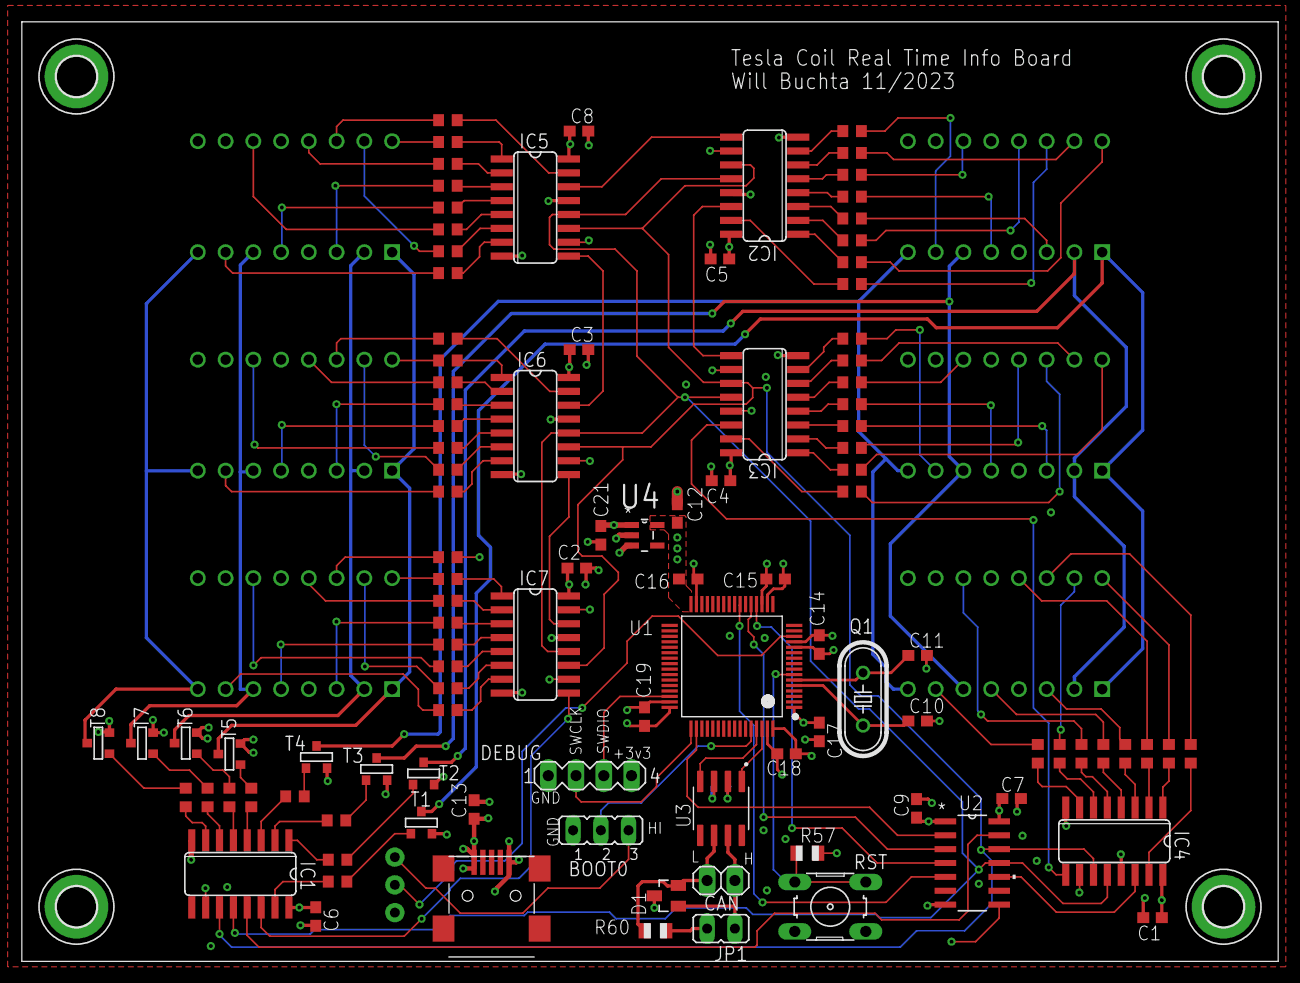
[picture p13: board main_board.brd from above]

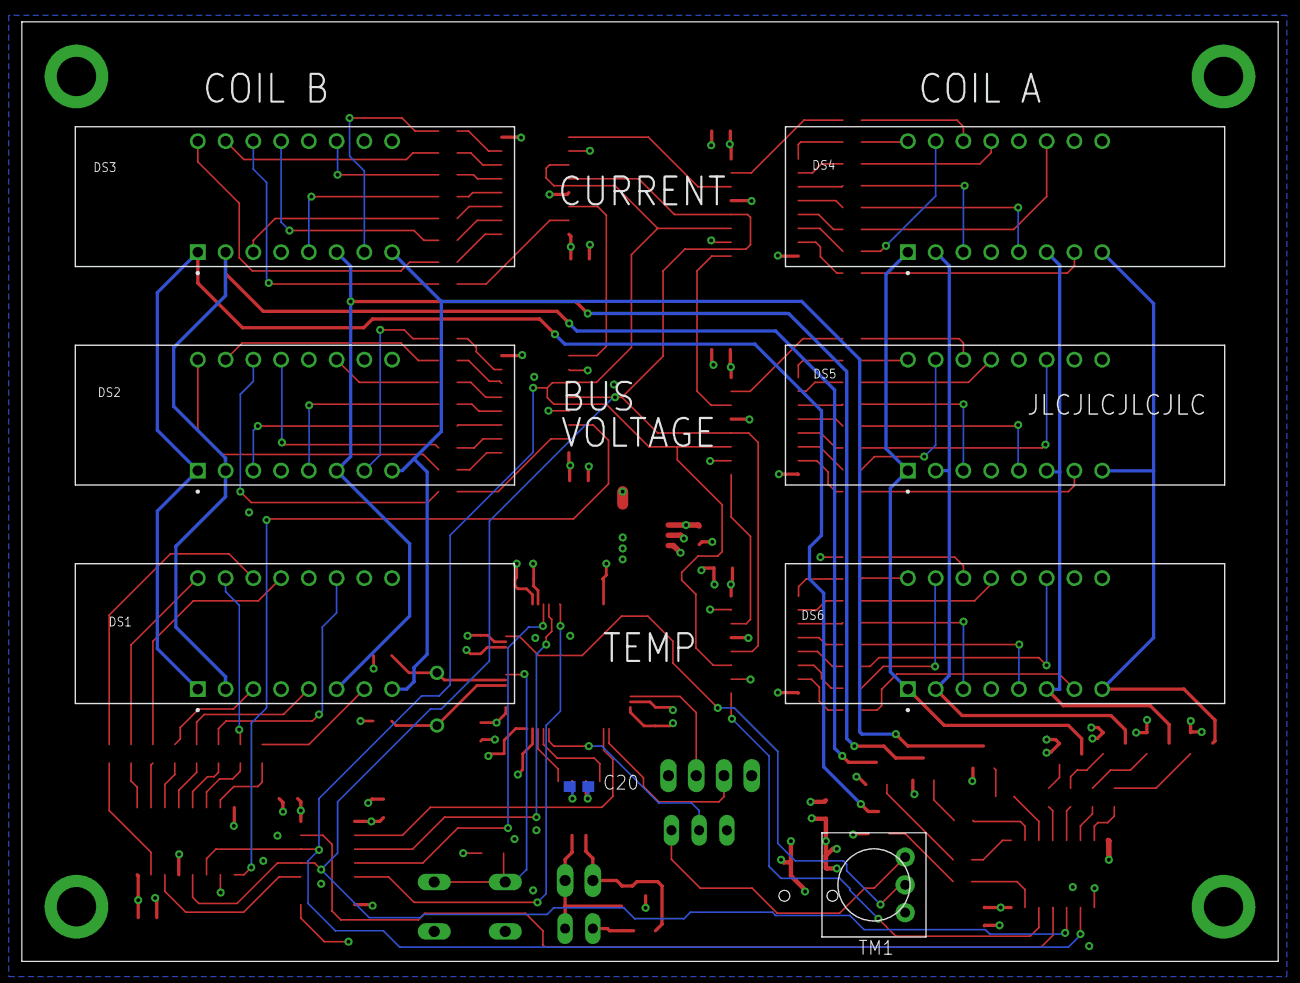
[picture p14: board main_board.brd from below]

Board: 4 copper layers, 115.0 x 86.0 mm, 117 parts (8 on the bottom side), 149 nets.
