buchtawill/TeslaCoilController/temp_volt_amp_board/CAD/rev1_eagle/reva.brd

## EAGLE design temp_volt_amp_board/CAD/rev1_eagle/reva.brd (2024-10-24)

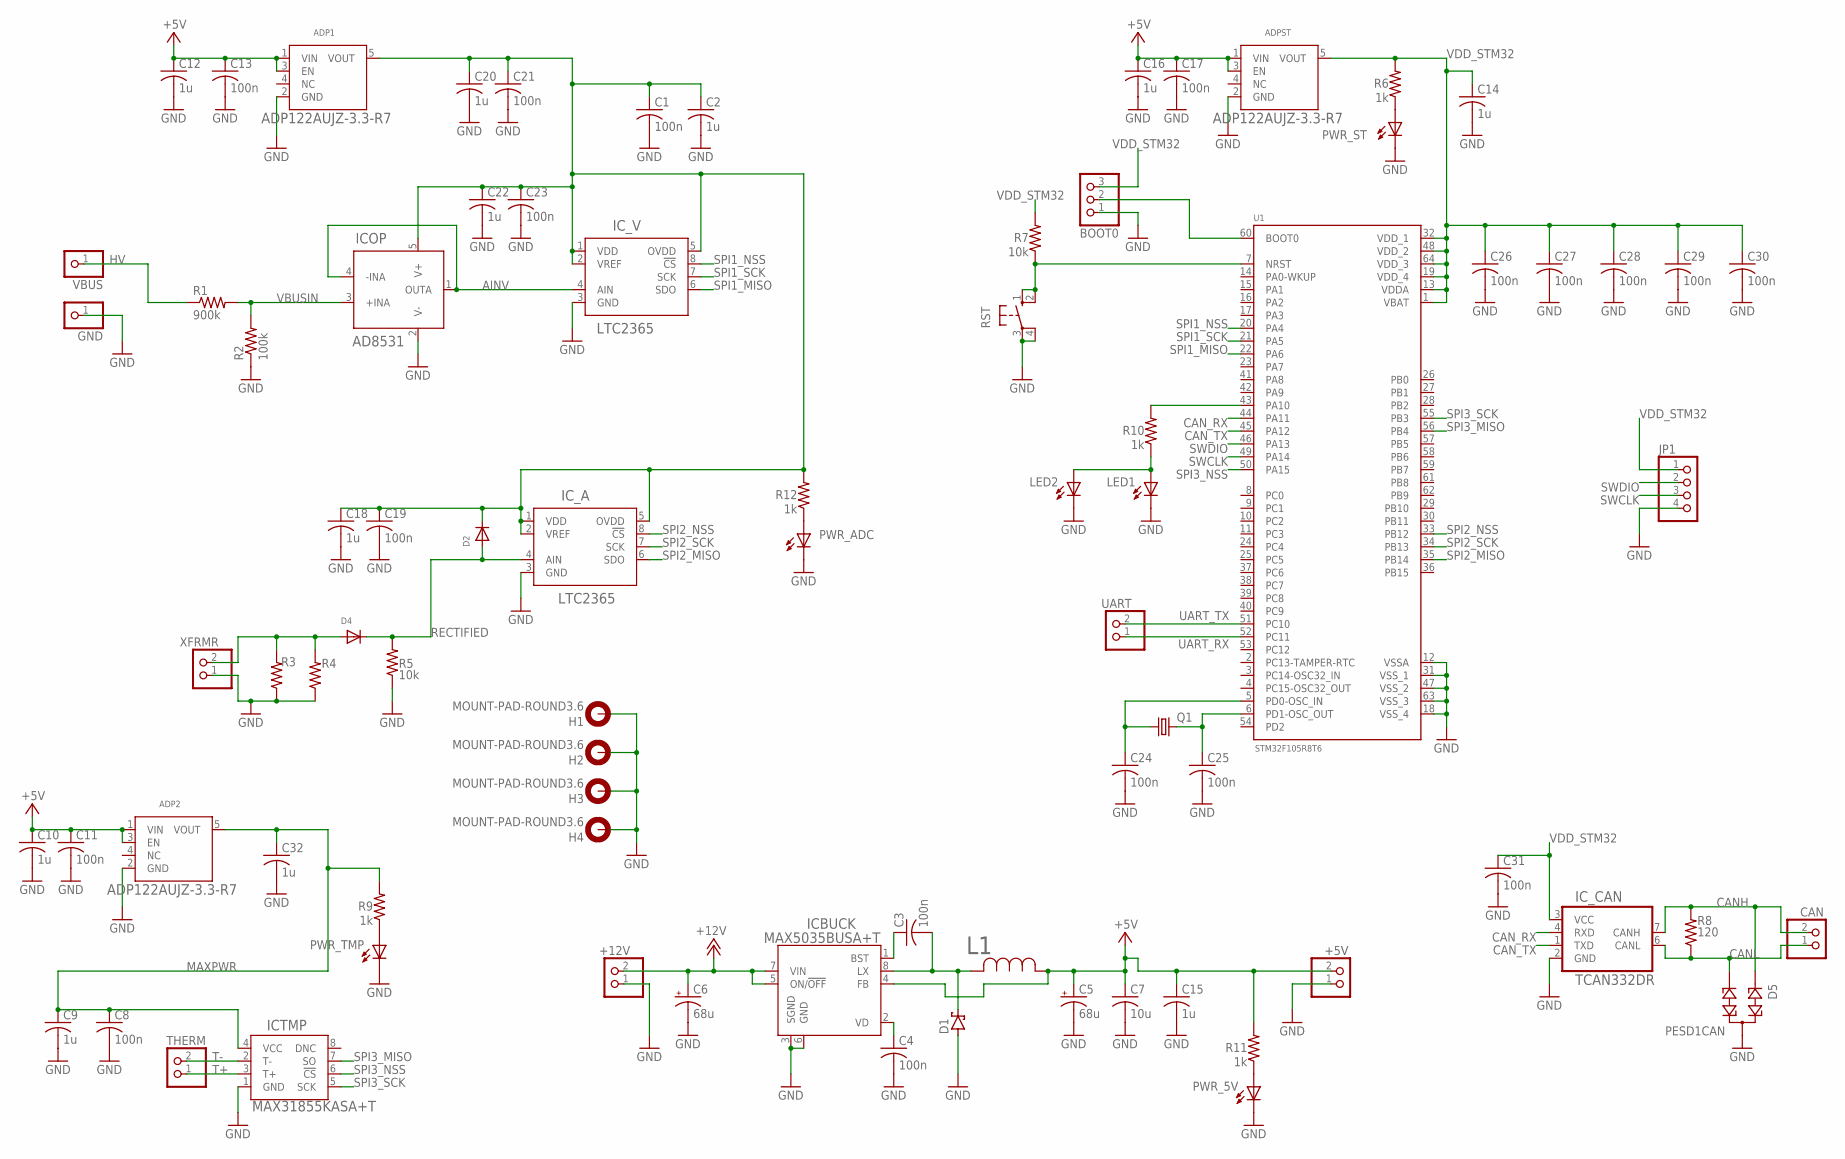
[picture p15: schematic reva.sch]

Parts:
+5V, +12V: PINHD-1X2; 1X02
ADP1, ADP2: ADP122AUJZ-3.3-R7; SOT95P280X100-5N
ADPST: ADP122AUJZ-3.3-R7; SOT95P280X100-5N
BOOT0: PINHD-1X3; 1X03
C1, C3, C4, C8, C11, C13, C17, C19, C21, C23, C24, C25, C26, C27, C28, C29, C30, C31: 100n; C0603
C2, C9, C10, C12, C14, C15, C16, C18, C20, C22, C32: 1u; C0603
C5, C6: 68u; E5-8,5
C7: 10u; C0805
CAN: PINHD-1X2; 1X02
D1: SCHOTTKY-DIODESMD; SMB
D2, D4: DIODESOD-523; SOD-523
D5: PESD1CAN; SOT23
GND: PINHD-1X1CB; 1X01-CLEANBIG
H1, H2, H3, H4: MOUNT-PAD-ROUND3.6; 3,6-PAD
ICBUCK: MAX5035BUSA+T; 21-0041B_8_MXM
ICOP: AD8531; RJ_5_ADI
ICTMP: MAX31855KASA+T; 21-0041B_8_MXM
IC_A: LTC2365; TSOT-23_TS8_LIT
IC_CAN: TCAN332DR; SOIC127P599X175-8N
IC_V: LTC2365; TSOT-23_TS8_LIT
JP1: PINHD-1X4; 1X04
L1: IHLP4040DZER101M11; IND_IHLP-4040DZ_VIS
LED1: LED5MM
LED2: LEDCHIP-LED0805; CHIP-LED0805
PWR_5V: LEDCHIP-LED0805; CHIP-LED0805
PWR_ADC: LEDCHIP-LED0805; CHIP-LED0805
PWR_ST: LEDCHIP-LED0805; CHIP-LED0805
PWR_TMP: LEDCHIP-LED0805; CHIP-LED0805
Q1: CRYSTALHC49S; HC49/S
R1: 900k; R0805
R2: 100k; R0805
R3: R-US_R0805; R0805
R4: R-US_0204/7; 0204/7
R5, R7: 10k; R0805
R6, R9, R10, R11, R12: 1k; R0805
R8: 120; R0805
RST: 10-XX; B3F-10XX
THERM: PINHD-1X2; 1X02
U1: STM32F105R8T6; QFP50P1200X1200X160-64N
UART: PINHD-1X2; 1X02
VBUS: PINHD-1X1CB; 1X01-CLEANBIG
XFRMR: PINHD-1X2; 1X02

Connections:
+5V: +5V.2, ADP1.1 (VIN), ADP1.3 (EN), ADP2.1 (VIN), ADP2.3 (EN), ADPST.1 (VIN), ADPST.3 (EN), C5.+, C7.1, C10.1, C11.1, C12.1, C13.1, C15.1, C16.1, C17.1, ICBUCK.4 (FB), L1.1, R11.2
+12V: +12V.2, C6.+, ICBUCK.5 (ON/!OFF), ICBUCK.7 (VIN)
AINV: ICOP.1 (OUTA), ICOP.4 (-INA), IC_V.4 (AIN)
CANH: CAN.2, D5.1, IC_CAN.7 (CANH), R8.2
CANL: CAN.1, D5.2, IC_CAN.6 (CANL), R8.1
CAN_RX: IC_CAN.4 (RXD), U1.44 (PA11)
CAN_TX: IC_CAN.1 (TXD), U1.45 (PA12)
CUR+: D4.A, R3.2, R4.2, XFRMR.2
GND: +5V.1, +12V.1, ADP1.2 (GND), ADP2.2 (GND), ADPST.2 (GND), BOOT0.1, C1.2, C2.2, C4.2, C5.-, C6.-, C7.2, C8.2, C9.2, C10.2, C11.2, C12.2, C13.2, C14.2, C15.2, C16.2, C17.2, C18.2, C19.2, C20.2, C21.2, C22.2, C23.2, C24.2, C25.2, C26.2, C27.2, C28.2, C29.2, C30.2, C31.2, C32.2, D1.A, D5.3, GND.1, H1.B3,6, H2.B3,6, H3.B3,6, H4.B3,6, ICBUCK.3 (SGND), ICBUCK.6 (GND), ICOP.2 (V-), ICTMP.1 (GND), IC_A.3 (GND), IC_CAN.2 (GND), IC_V.3 (GND), JP1.4, LED1.K (C), LED2.C, PWR_5V.C, PWR_ADC.C, PWR_ST.C, PWR_TMP.C, R2.1, R3.1, R4.1, R5.1, RST.3, RST.4 (P1), U1.12 (VSSA), U1.18 (VSS_4), U1.31 (VSS_1), U1.47 (VSS_2), U1.63 (VSS_3), XFRMR.1
HV: R1.1, VBUS.1
MAXPWR: ADP2.5 (VOUT), C8.1, C9.1, C32.1, ICTMP.4 (VCC), R9.2
unnamed: C3.2, D1.C, ICBUCK.8 (LX), L1.2
unnamed: C3.1, ICBUCK.1 (BST)
unnamed: PWR_ST.A, R6.1
unnamed: C4.1, ICBUCK.2 (VD)
unnamed: PWR_TMP.A, R9.1
unnamed: PWR_5V.A, R11.1
unnamed: PWR_ADC.A, R12.1
unnamed: R7.1, RST.1 (S), RST.2 (S1), U1.7 (NRST)
unnamed: R10.2, U1.43 (PA10)
unnamed: LED1.A, LED2.A, R10.1
unnamed: BOOT0.2, U1.60 (BOOT0)
unnamed: C24.1, Q1.1, U1.5 (PD0-OSC_IN)
unnamed: C25.1, Q1.2, U1.6 (PD1-OSC_OUT)
RECTIFIED: D2.A, D4.K (C), IC_A.4 (AIN), R5.2
SPI1_MISO: IC_V.6 (SDO), U1.22 (PA6)
SPI1_NSS: IC_V.8 (!CS), U1.20 (PA4)
SPI1_SCK: IC_V.7 (SCK), U1.21 (PA5)
SPI2_MISO: IC_A.6 (SDO), U1.35 (PB14)
SPI2_NSS: IC_A.8 (!CS), U1.33 (PB12)
SPI2_SCK: IC_A.7 (SCK), U1.34 (PB13)
SPI3_MISO: ICTMP.7 (SO), U1.56 (PB4)
SPI3_NSS: ICTMP.6 (!CS), U1.50 (PA15)
SPI3_SCK: ICTMP.5 (SCK), U1.55 (PB3)
SWCLK: JP1.3, U1.49 (PA14)
SWDIO: JP1.2, U1.46 (PA13)
T+: ICTMP.3 (T+), THERM.1
T-: ICTMP.2 (T-), THERM.2
UART_RX: U1.52 (PC11), UART.1
UART_TX: U1.51 (PC10), UART.2
VBUSIN: ICOP.3 (+INA), R1.2, R2.2
VDD_OP: ADP1.5 (VOUT), C1.1, C2.1, C18.1, C19.1, C20.1, C21.1, C22.1, C23.1, D2.K (C), ICOP.5 (V+), IC_A.1 (VDD), IC_A.2 (VREF), IC_A.5 (OVDD), IC_V.1 (VDD), IC_V.2 (VREF), IC_V.5 (OVDD), R12.2
VDD_STM32: ADPST.5 (VOUT), BOOT0.3, C14.1, C26.1, C27.1, C28.1, C29.1, C30.1, C31.1, IC_CAN.3 (VCC), JP1.1, R6.2, R7.2, U1.1 (VBAT), U1.13 (VDDA), U1.19 (VDD_4), U1.32 (VDD_1), U1.48 (VDD_2), U1.64 (VDD_3)

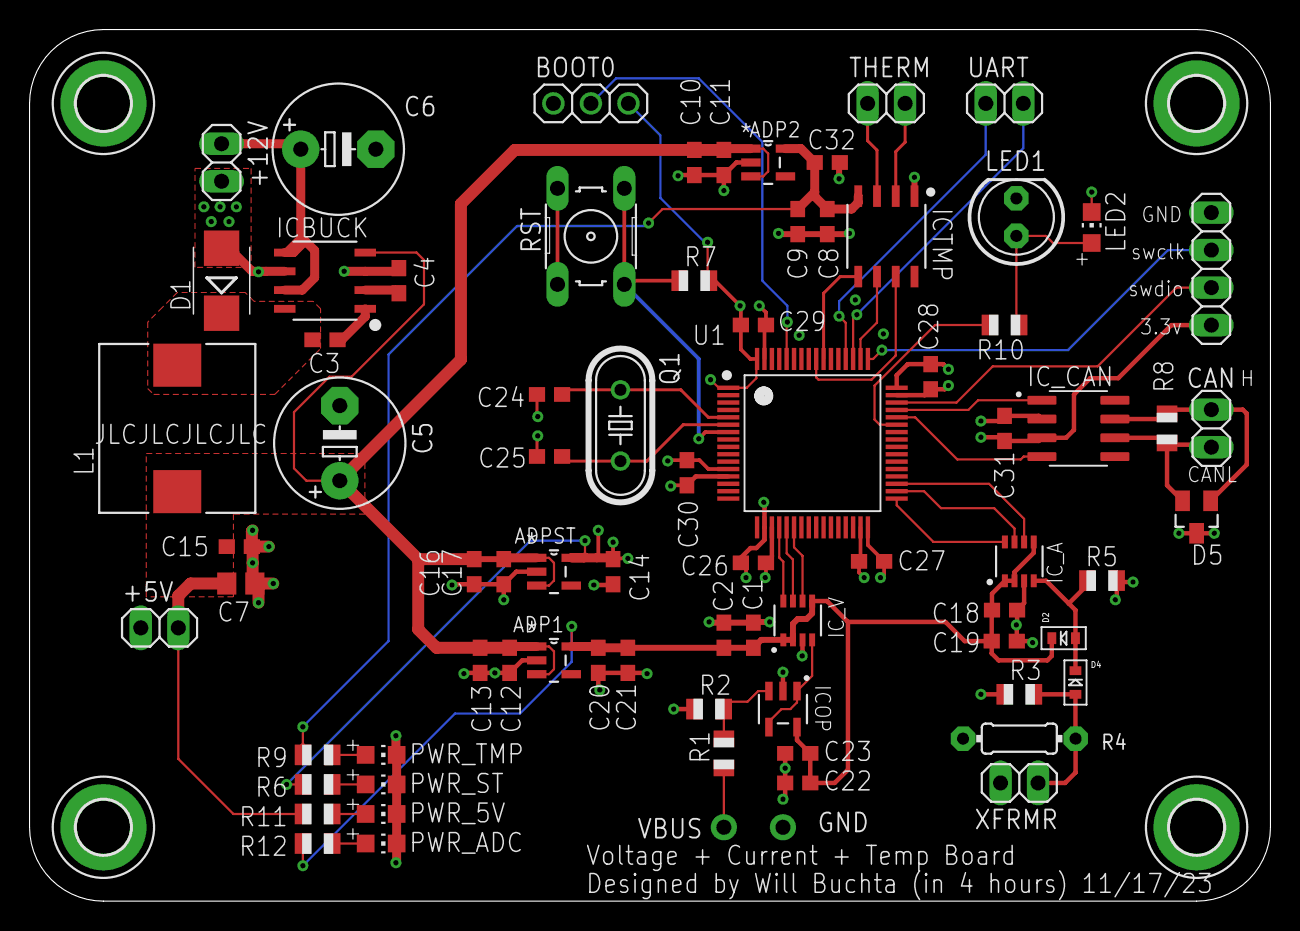
[picture p16: board reva.brd from above]

Board: 4 copper layers, 84.0 x 59.0 mm, 81 parts (0 on the bottom side), 43 nets.
