buchtawill/TeslaCoilController/L151_interrupter/interrupter-reva.brd

## EAGLE design L151_interrupter/interrupter-reva.brd (2025-08-04)

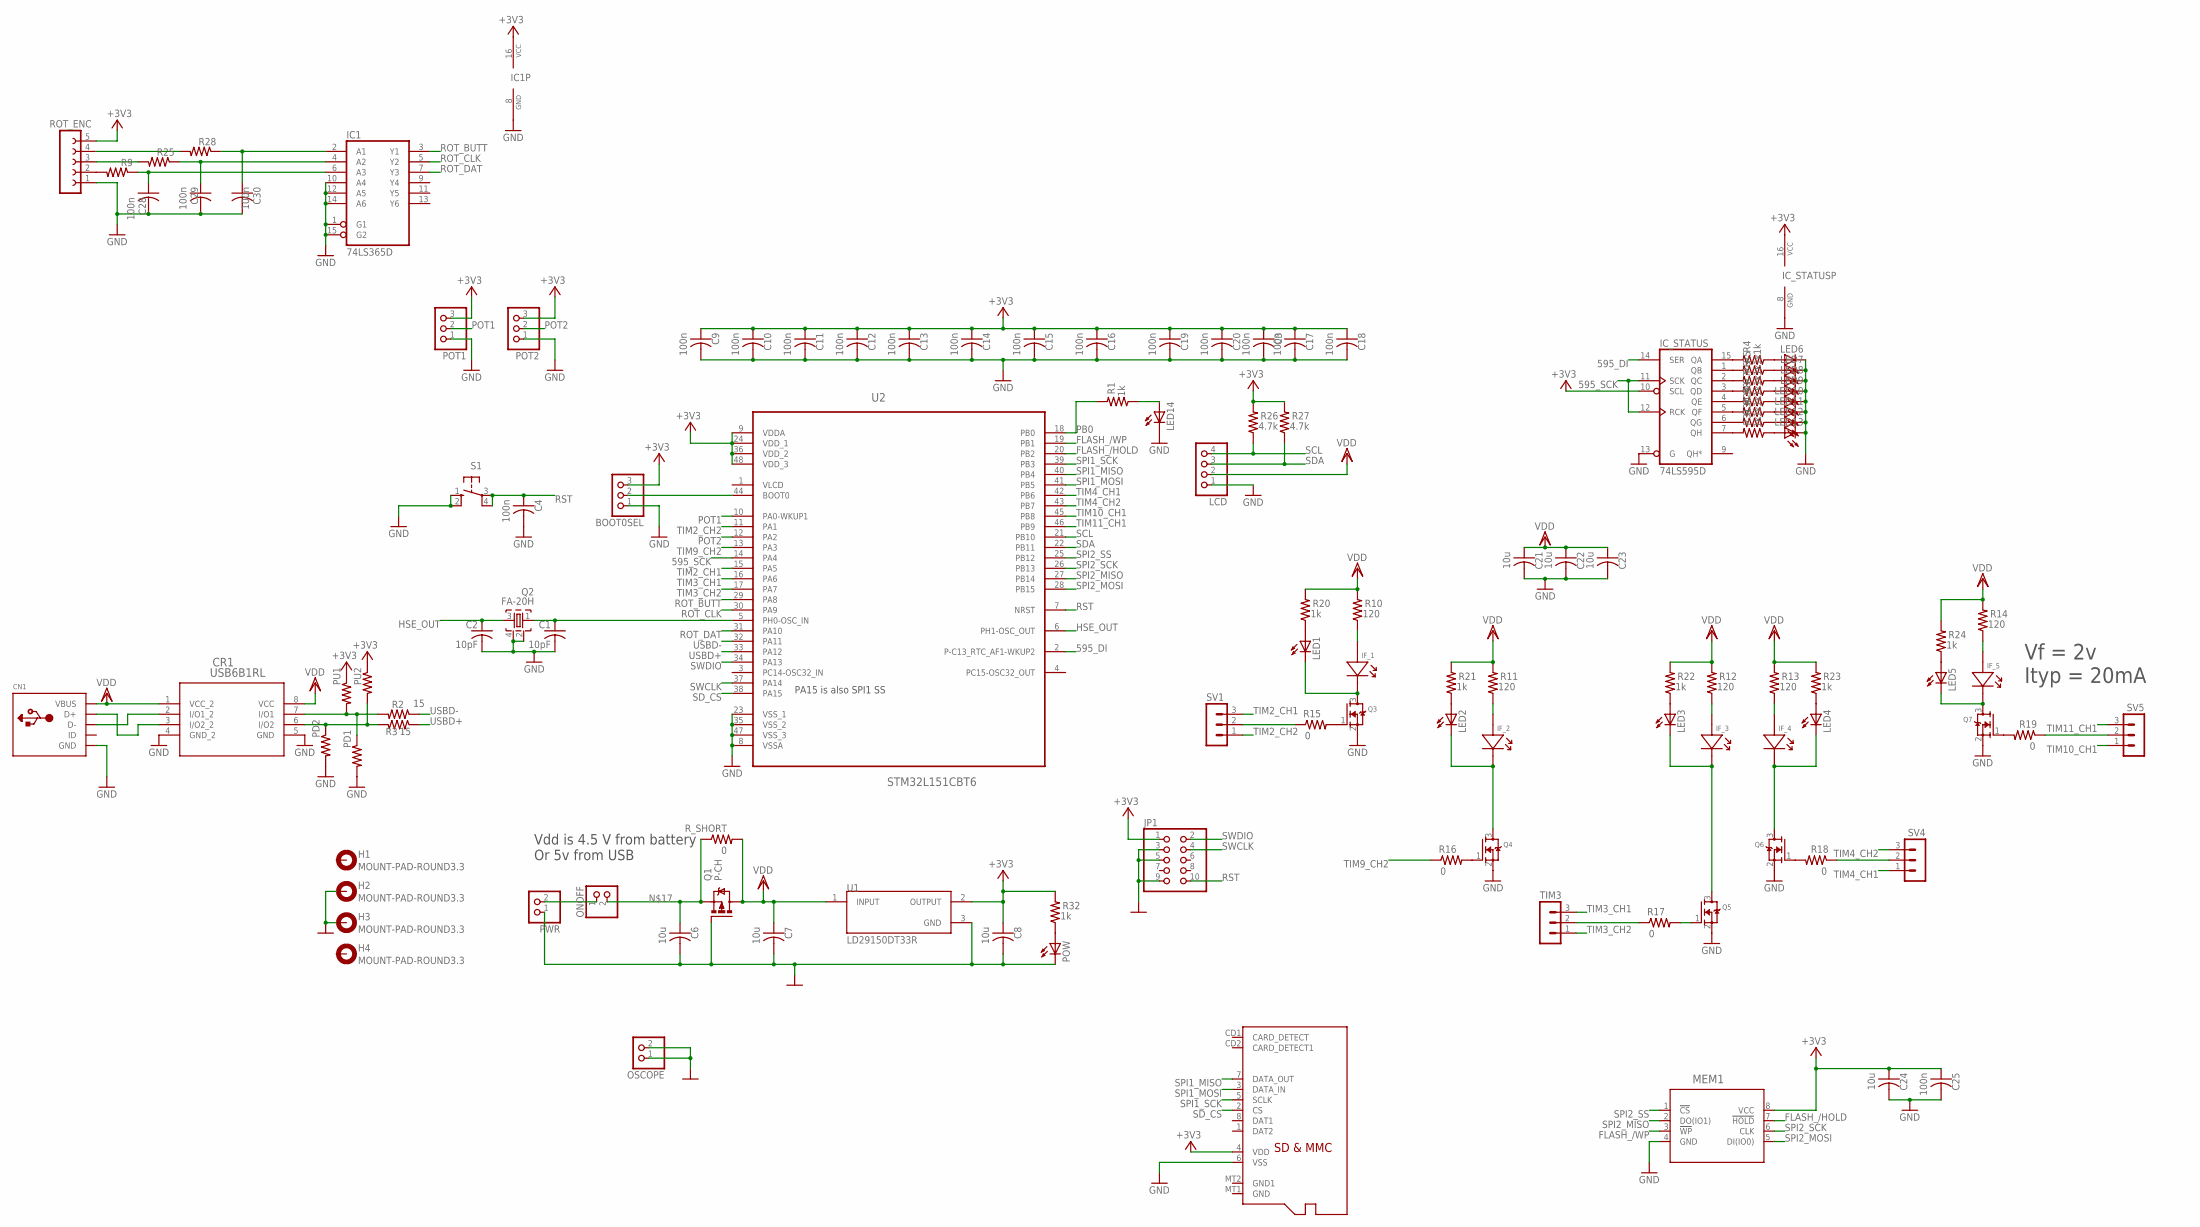
[picture p17: schematic interrupter-reva.sch]

Parts:
BOOT0SEL: PINHD-1X3; 1X03
C1, C2: 10pF; C0603
C3, C9, C11, C13, C15, C17, C20, C25: 100n; C0805
C4: 100n; C0402
C6, C7, C21, C22, C23: 10u; C0805
C8, C24: 10u; C0603
C10, C12, C14, C16, C18, C19, C28, C29, C30: 100n; C0603
CN1: USBMINIB; USB-MINIB
CR1: USB6B1RL; SO-8_STM
H1, H2, H3, H4: MOUNT-PAD-ROUND3.3; 3,3-PAD
IC1: 74LS365D; SO16
IC_STATUS: 74LS595D; SO16
IF_1, IF_2, IF_3, IF_4, IF_5: IF-E96E
JP1: PINHD-2X5; 2X05
LCD: PINHD-1X4; 1X04
LED1, LED2, LED3, LED4, LED5, LED6, LED7, LED8, LED9, LED10, LED11, LED12, LED13, LED14: LEDCHIP-LED0805; CHIP-LED0805
MEM1: W25X40CLSNIG; WIN_SN-8_WIN
ONOFF: PINHD-1X2; 1X02
OSCOPE: PINHD-1X2; 1X02
PD1, PD2: 15; R0603
POT1, POT2: PINHD-1X3; 1X03
POW: LEDCHIP-LED0805; CHIP-LED0805
PU1, PU2: 15; R0603
PWR: PINHD-1X2; 1X02
Q1: P-CH; MICRO3
Q2: FA-20H
Q3, Q4, Q5, Q6, Q7: MOSFET-NREFLOW; SOT23
R1, R4, R5, R6, R7, R8, R29, R30, R31, R32: 1k; R0603
R2, R3: 15; R0603
R9, R25, R28: R-US_R0603; R0603
R10, R11, R12, R13, R14: 120; R0805
R15, R16, R17, R18, R19: 0; R0805
R20, R21, R22, R23, R24: 1k; R0805
R26, R27: 4.7k; R0805
ROT_ENC: FE05-1
R_SHORT: 0; R0805
S1: 10-XX; B3F-10XX
SV1, SV4, SV5: MA03-1
TIM3: MA03-1
U1: LD29150DT33R; DPAK456P972X240-3N
U2: STM32L151CBT6; QFP50P900X900X160-48N
U$1: MICROSD

Connections:
595_DI: IC_STATUS.14 (SER), U2.2 (P-C13_RTC_AF1-WKUP2)
595_SCK: IC_STATUS.11 (SCK), IC_STATUS.12 (RCK), U2.14 (PA4)
+3V3: BOOT0SEL.3, C3.1, C8.1, C9.1, C10.1, C11.1, C12.1, C13.1, C14.1, C15.1, C16.1, C17.1, C18.1, C19.1, C20.1, C24.1, C25.1, IC1.16 (VCC), IC_STATUS.10 (SCL), IC_STATUS.16 (VCC), JP1.1, MEM1.8 (VCC), POT1.3, POT2.3, PU1.1, PU2.1, R26.2, R27.2, R32.2, ROT_ENC.5, U1.2 (OUTPUT), U2.9 (VDDA), U2.24 (VDD_1), U2.36 (VDD_2), U2.48 (VDD_3), U$1.4 (VDD)
FLASH_/HOLD: MEM1.7 (!HOLD), U2.20 (PB2)
FLASH_/WP: MEM1.3 (!WP), U2.19 (PB1)
GND: BOOT0SEL.1, C1.2, C2.2, C3.2, C4.2, C6.2, C7.2, C8.2, C9.2, C10.2, C11.2, C12.2, C13.2, C14.2, C15.2, C16.2, C17.2, C18.2, C19.2, C20.2, C21.2, C22.2, C23.2, C24.2, C25.2, C28.2, C29.2, C30.2, CN1.GND, CR1.4 (GND_2), CR1.5 (GND), H2.B3,3, H3.B3,3, IC1.1 (G1), IC1.8 (GND), IC1.10 (A4), IC1.12 (A5), IC1.14 (A6), IC1.15 (G2), IC_STATUS.8 (GND), IC_STATUS.13 (G), JP1.3, JP1.5, JP1.9, LCD.1, LED6.C, LED7.C, LED8.C, LED9.C, LED10.C, LED11.C, LED12.C, LED13.C, LED14.C, MEM1.4 (GND), OSCOPE.1, OSCOPE.2, PD1.2, PD2.2, POT1.1, POT2.1, POW.C, PWR.1, Q1.1 (G), Q2.2, Q2.4, Q3.2 (S), Q4.2 (S), Q5.2 (S), Q6.2 (S), Q7.2 (S), ROT_ENC.1, S1.1 (S), S1.2 (S1), U1.3 (GND), U2.8 (VSSA), U2.23 (VSS_1), U2.35 (VSS_2), U2.47 (VSS_3), U$1.6 (VSS)
HSE_OUT: C2.1, Q2.3, U2.6 (PH1-OSC_OUT)
unnamed: R9.2, ROT_ENC.2
unnamed: LED1.A, R20.1
unnamed: CN1.D-, CR1.2 (I/O1_2)
unnamed: LED2.A, R21.1
unnamed: LED3.A, R22.1
unnamed: LED5.A, R24.1
unnamed: IF_1.ANODE, R10.1
unnamed: IF_2.ANODE, R11.1
unnamed: IF_3.ANODE, R12.1
unnamed: IF_4.ANODE, R13.1
unnamed: IF_5.ANODE, R14.1
unnamed: IF_1.CATHODE, LED1.C, Q3.3 (D)
unnamed: IF_2.CATHODE, LED2.C, Q4.3 (D)
unnamed: IF_3.CATHODE, LED3.C, Q5.3 (D)
unnamed: IF_4.CATHODE, LED4.C, Q6.3 (D)
unnamed: IF_5.CATHODE, LED5.C, Q7.3 (D)
unnamed: C6.1, ONOFF.2, Q1.2 (S), R_SHORT.1
unnamed: ONOFF.1, PWR.2
unnamed: CN1.D+, CR1.3 (I/O2_2)
unnamed: CR1.7 (I/O1), PD1.1, PU1.2, R2.2
unnamed: R25.2, ROT_ENC.3
unnamed: Q7.1 (G), R19.2
unnamed: R28.2, ROT_ENC.4
unnamed: CR1.6 (I/O2), PD2.1, PU2.2, R3.2
unnamed: LED4.A, R23.1
unnamed: C28.1, IC1.6 (A3), R9.1
unnamed: C29.1, IC1.4 (A2), R25.1
unnamed: C30.1, IC1.2 (A1), R28.1
unnamed: LED6.A, R4.1
unnamed: IC_STATUS.15 (QA), R4.2
unnamed: C1.1, Q2.1, U2.5 (PH0-OSC_IN)
unnamed: LED7.A, R5.1
unnamed: IC_STATUS.1 (QB), R5.2
unnamed: LED8.A, R6.1
unnamed: IC_STATUS.2 (QC), R6.2
unnamed: LED9.A, R7.1
unnamed: IC_STATUS.3 (QD), R7.2
unnamed: LED10.A, R8.1
unnamed: IC_STATUS.4 (QE), R8.2
unnamed: LED11.A, R29.1
unnamed: IC_STATUS.5 (QF), R29.2
unnamed: LED12.A, R30.1
unnamed: IC_STATUS.6 (QG), R30.2
unnamed: BOOT0SEL.2, U2.44 (BOOT0)
unnamed: R15.1, SV1.2
unnamed: Q3.1 (G), R15.2
unnamed: Q4.1 (G), R16.2
unnamed: LED13.A, R31.1
unnamed: Q5.1 (G), R17.2
unnamed: R17.1, TIM3.2
unnamed: Q6.1 (G), R18.2
unnamed: R18.1, SV4.2
unnamed: R19.1, SV5.2
unnamed: IC_STATUS.7 (QH), R31.2
unnamed: LED14.A, R1.1
unnamed: POW.A, R32.1
PB0: R1.2, U2.18 (PB0)
POT1: POT1.2, U2.10 (PA0-WKUP1)
POT2: POT2.2, U2.12 (PA2)
ROT_BUTT: IC1.3 (Y1), U2.29 (PA8)
ROT_CLK: IC1.5 (Y2), U2.30 (PA9)
ROT_DAT: IC1.7 (Y3), U2.31 (PA10)
RST: C4.1, JP1.10, S1.3, S1.4 (P1), U2.7 (NRST)
SCL: LCD.4, R26.1, U2.21 (PB10)
SDA: LCD.3, R27.1, U2.22 (PB11)
SD_CS: U2.38 (PA15), U$1.2 (CS)
SPI1_MISO: U2.40 (PB4), U$1.7 (DATA_OUT)
SPI1_MOSI: U2.41 (PB5), U$1.3 (DATA_IN)
SPI1_SCK: U2.39 (PB3), U$1.5 (SCLK)
SPI2_MISO: MEM1.2 (DO(IO1)), U2.27 (PB14)
SPI2_MOSI: MEM1.5 (DI(IO0)), U2.28 (PB15)
SPI2_SCK: MEM1.6 (CLK), U2.26 (PB13)
SPI2_SS: MEM1.1 (!CS), U2.25 (PB12)
SWCLK: JP1.4, U2.37 (PA14)
SWDIO: JP1.2, U2.34 (PA13)
TIM2_CH1: SV1.3, U2.15 (PA5)
TIM2_CH2: SV1.1, U2.11 (PA1)
TIM3_CH1: TIM3.3, U2.16 (PA6)
TIM3_CH2: TIM3.1, U2.17 (PA7)
TIM4_CH1: SV4.1, U2.42 (PB6)
TIM4_CH2: SV4.3, U2.43 (PB7)
TIM9_CH2: R16.1, U2.13 (PA3)
TIM10_CH1: SV5.1, U2.45 (PB8)
TIM11_CH1: SV5.3, U2.46 (PB9)
USBD+: R3.1, U2.33 (PA12)
USBD-: R2.1, U2.32 (PA11)
VDD: C7.1, C21.1, C22.1, C23.1, CN1.VBUS, CR1.1 (VCC_2), CR1.8 (VCC), LCD.2, Q1.3 (D), R10.2, R11.2, R12.2, R13.2, R14.2, R20.2, R21.2, R22.2, R23.2, R24.2, R_SHORT.2, U1.1 (INPUT)
VLCD: U2.1 (VLCD)

Notes on the sheet:
Vf = 2v Ityp = 20mA
Vdd is 4.5 V from battery Or 5v from USB
PA15 is also SPI1 SS
