buchtawill/TeslaCoilController/L151_interrupter/interrupter-reva.brd

## EAGLE design L151_interrupter/interrupter-reva.brd (continued)

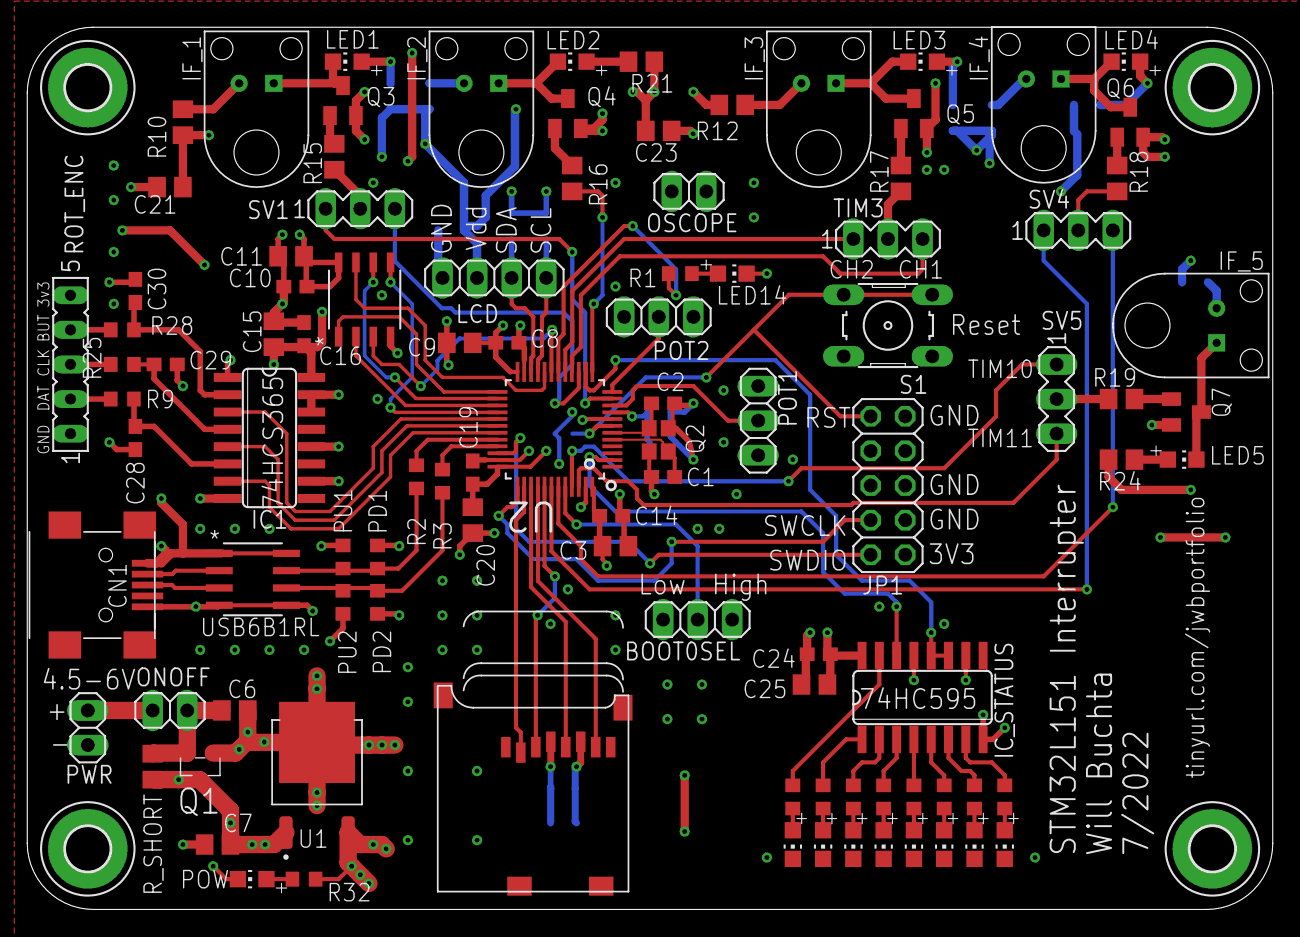
[picture p18: board interrupter-reva.brd from above]

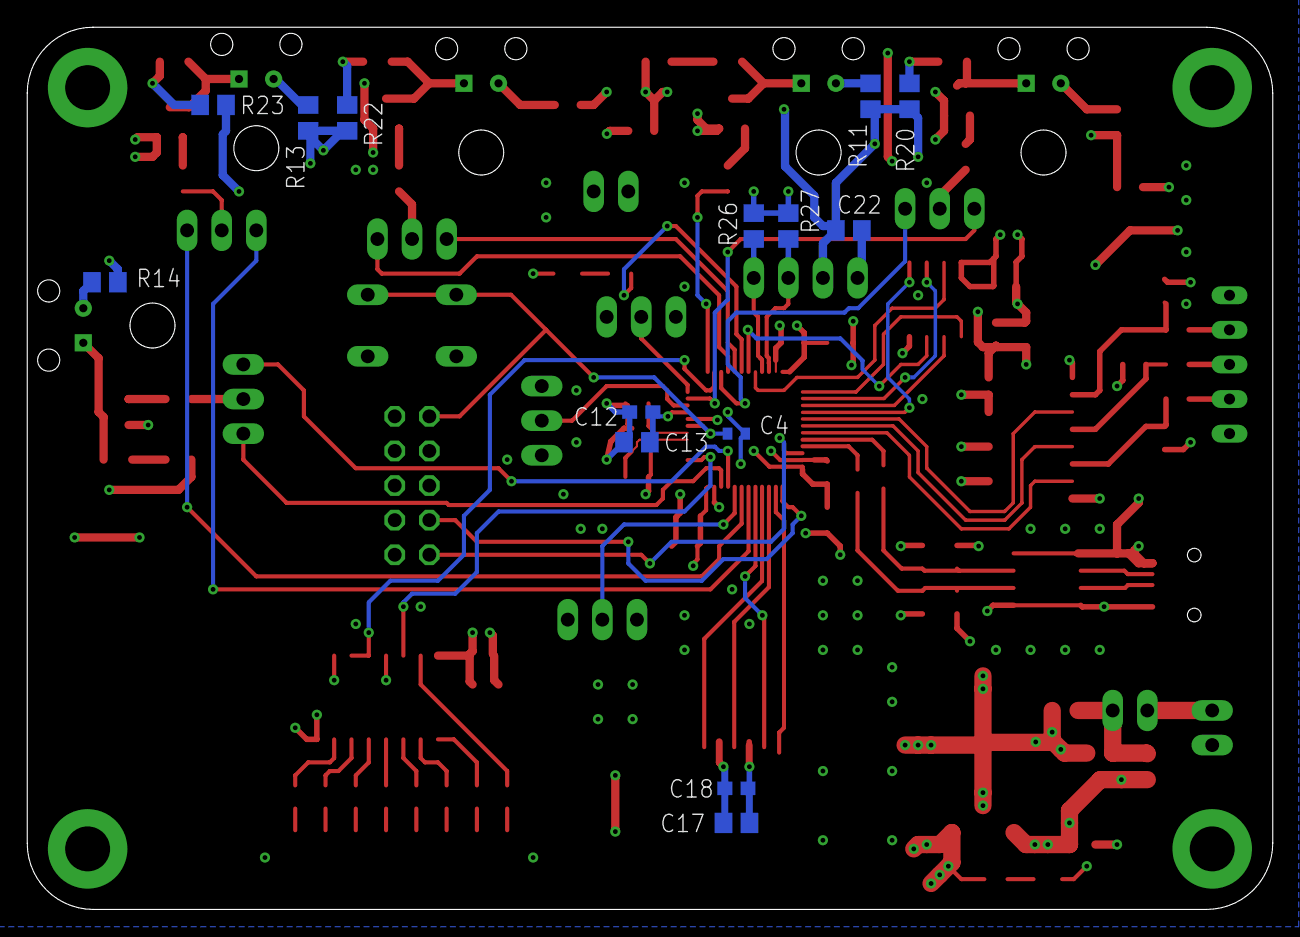
[picture p19: board interrupter-reva.brd from below]

Board: 4 copper layers, 91.4 x 64.8 mm, 117 parts (14 on the bottom side), 94 nets.
