buchtawill/TeslaCoilController/Rev2_F401RE/eagle/revb.brd

## EAGLE design Rev2_F401RE/eagle/revb.brd (2025-02-25)

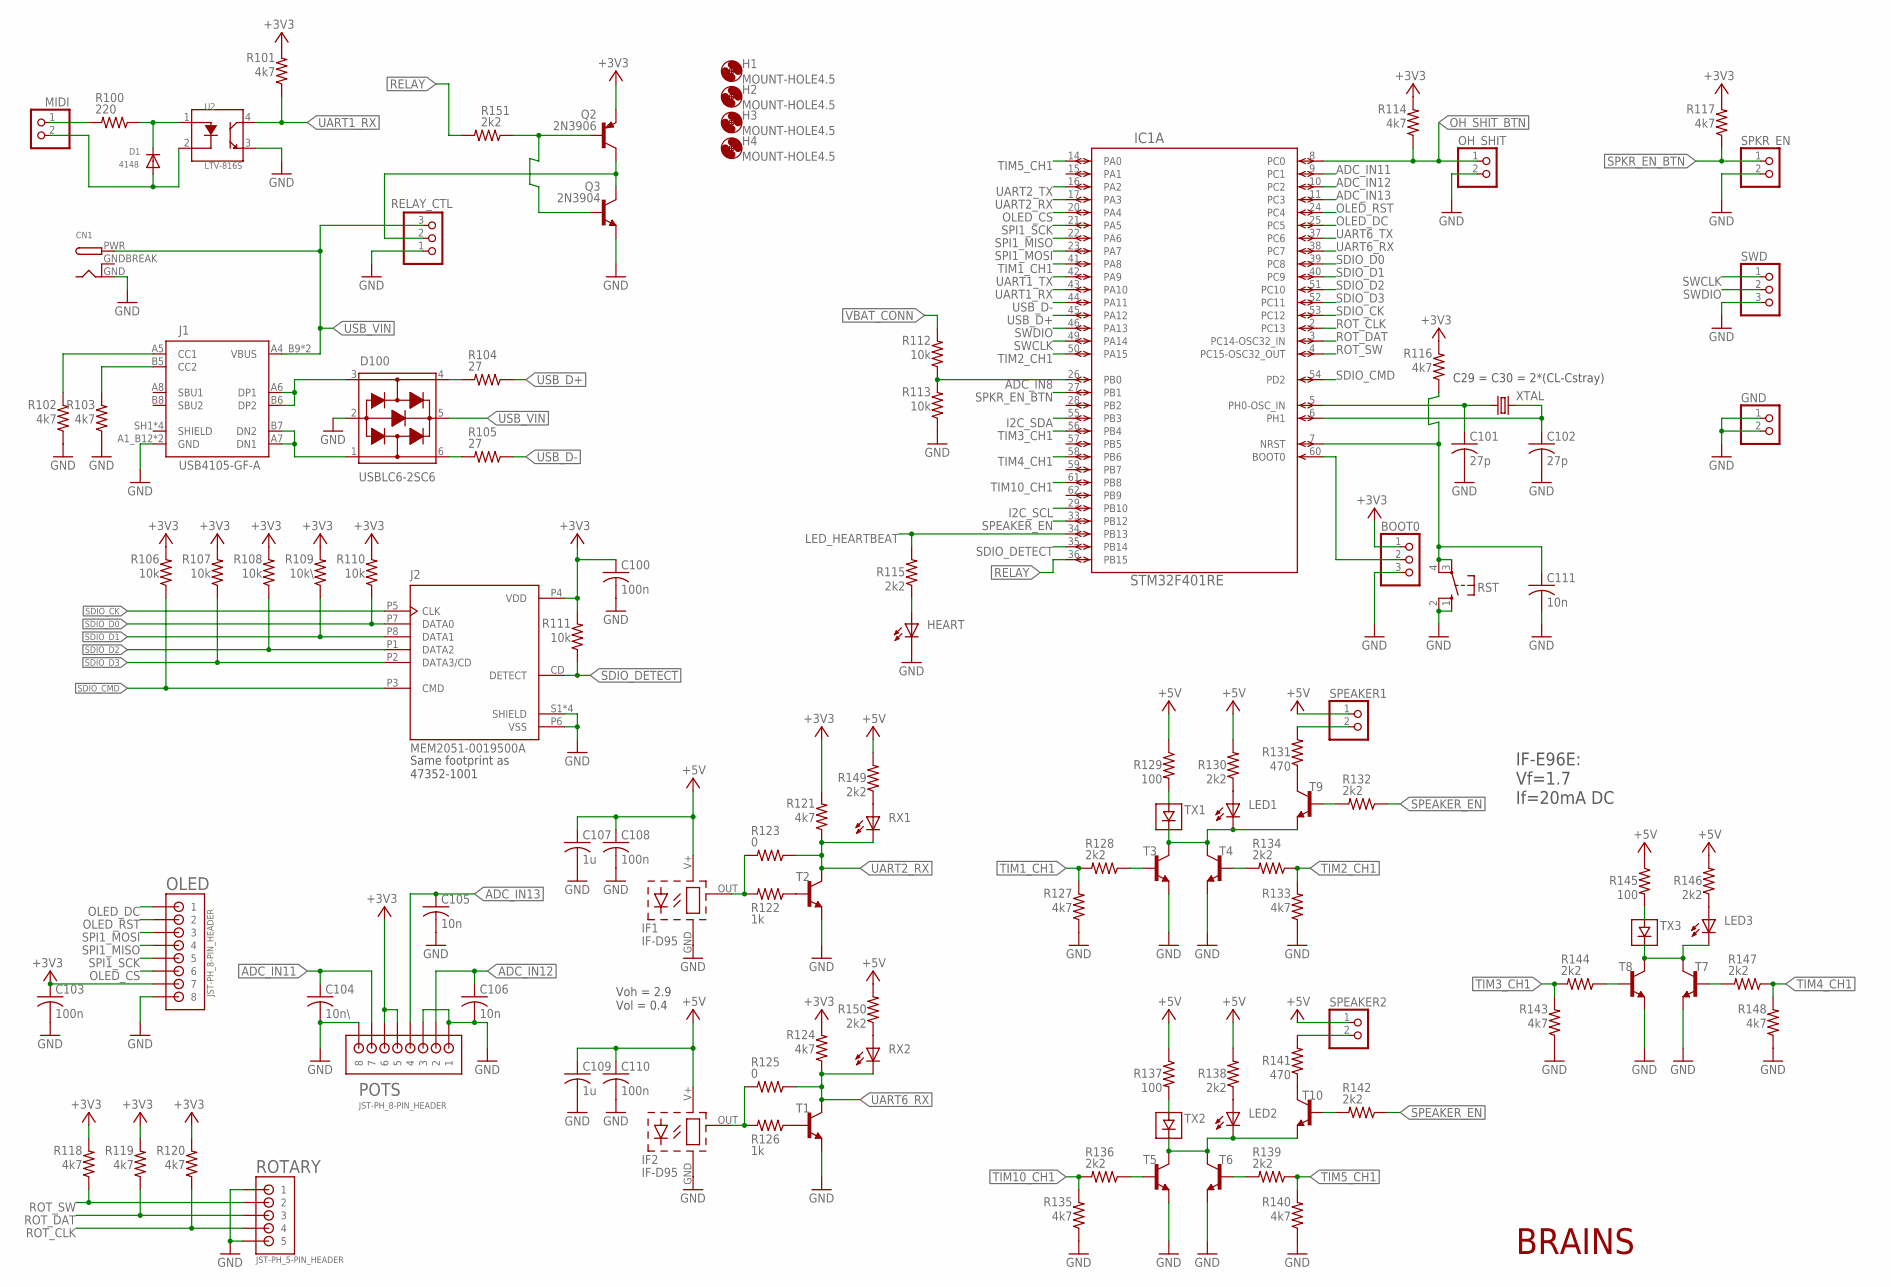
[picture p20: schematic revb.sch, sheet 1]

Parts:
BOOT0: PINHD-1X3; 1X03
C100, C103, C108, C110: 100n; C0603K
C101, C102: 27p; C0402
C104: 10n\; C0603K
C105, C106, C111: 10n; C0603K
C107, C109: 1u; C0603K
CN1: DCBARRELPTH; DCJACK_2MM_PTH
D1: 4148; SOD-123
D100: USBLC6-2SC6; SOT95P280X145-6N
GND: PINHD-1X2; 1X02
H1, H2, H3, H4: MOUNT-HOLE4.5; 4,5
HEART: LEDCHIPLED_0805; CHIPLED_0805
IC1: STM32F401RE; LQFP64-10X10MM
IF1, IF2: IF-D95; IFD95
J1: USB4105-GF-A; GCT_USB4105-GF-A
J2: MEM2051-0019500A; GCT_MEM2051-00-195-00-A_REVD1
LED1, LED2, LED3: LEDCHIPLED_0805; CHIPLED_0805
MIDI: PINHD-1X2; 1X02
OH_SHIT: PINHD-1X2; 1X02
OLED: JST-PH_8-PIN_HEADER; JST_B8B-PH_HEADER
POTS: JST-PH_8-PIN_HEADER; JST_B8B-PH_HEADER
Q2: 2N3906; TO92
Q3: 2N3904; TO92
R100: 220; R0603
R101, R102, R103, R114, R116, R117, R118, R119, R120, R121, R124, R127, R133, R135, R140, R143, R148: 4k7; R0603
R104, R105: 27; R0603
R106, R107, R108, R110, R111, R112, R113: 10k; R0805
R109: 10k\; R0805
R115, R128, R130, R132, R134, R136, R138, R139, R142, R144, R146, R147, R149, R150, R151: 2k2; R0603
R122, R126: 1k; R0805
R123, R125: 0; R0603
R129, R137, R145: 100; R0805
R131, R141: 470; R0603
RELAY_CTL: PINHD-1X3; 1X03
ROTARY: JST-PH_5-PIN_HEADER; JST_B5B-PH_HEADER
RST: 10-XX; B3F-10XX
RX1, RX2: LEDCHIPLED_0805; CHIPLED_0805
SPEAKER1, SPEAKER2: PINHD-1X2; 1X02
SPKR_EN: PINHD-1X2; 1X02
SWD: PINHD-1X3; 1X03
T1, T2, T3, T4, T5, T6, T7, T8, T9, T10: MMBTA06-7-F; SOT23-BEC
TX1, TX2, TX3: IF-E95E; IF-E96E
U2: LTV-816S; SMD4-2.54-4.6X6.5MM
XTAL: CRYSTALHC49S; HC49/S

Connections:
+3V3: BOOT0.1, C100.1, C103.1, J2.P4 (VDD), OLED.P7 (7), POTS.P5 (5), POTS.P6 (6), Q2.3 (E), R101.2, R106.2, R107.2, R108.2, R109.2, R110.2, R111.2, R114.2, R116.2, R117.2, R118.2, R119.2, R120.2, R121.2, R124.2; also elsewhere on the board
+5V: C107.1, C108.1, C109.1, C110.1, IF1.V+ (VCC), IF2.V+ (VCC), R129.1, R130.2, R137.1, R138.2, R145.1, R146.2, R149.2, R150.2, SPEAKER1.1, SPEAKER2.1; also elsewhere on the board
ADC_IN8: IC1.26 (PB0), R112.1, R113.2
ADC_IN11: C104.1, IC1.9 (PC1), POTS.P7 (7)
ADC_IN12: C106.1, IC1.10 (PC2), POTS.P2 (2)
ADC_IN13: C105.1, IC1.11 (PC3), POTS.P4 (4)
BOOT0_CONN: BOOT0.2, IC1.60 (BOOT0)
CC1: J1.A5 (CC1), R102.2
CC2: J1.B5 (CC2), R103.2
COIL1_B: R128.1, T3.B
COIL1_NEG: LED1.C, T3.C, T4.C, T9.E, TX1.GND
COIL1_POS: R129.2, TX1.SIG
COIL2_B: R136.1, T5.B
COIL2_NEG: LED2.C, T5.C, T6.C, T10.E, TX2.GND
COIL2_POS: R137.2, TX2.SIG
COIL3_B: R144.1, T8.B
COIL3_NEG: LED3.C, T7.C, T8.C, TX3.GND
COIL3_POS: R145.2, TX3.SIG
COIL12_B: R134.2, T4.B
COIL22_B: R139.2, T6.B
COIL32_B: R147.2, T7.B
GND: BOOT0.3, C100.2, C101.2, C102.2, C103.2, C104.2, C105.2, C106.2, C107.2, C108.2, C109.2, C110.2, C111.2, CN1.GND, D100.2 (GND), GND.1, GND.2, HEART.C, IF1.GND, IF2.GND, J1.A1_B12 (GND), J1.B1_A12 (GND), J2.P6 (VSS), J2.S1 (SHIELD), J2.S2 (SHIELD), J2.S3 (SHIELD), J2.S4 (SHIELD), OH_SHIT.2, OLED.P8 (8), POTS.P1 (1), POTS.P3 (3), POTS.P8 (8), Q3.3 (E), R102.1, R103.1, R113.1, R127.1, R133.1, R135.1, R140.1, R143.1, R148.1, RELAY_CTL.1, ROTARY.P1 (1), ROTARY.P5 (5), RST.1 (S), RST.2 (S1), SPKR_EN.2, SWD.3, T1.E, T2.E, T3.E, T4.E, T5.E, T6.E, T7.E, T8.E, U2.3 (EMITER); also elsewhere on the board
GNDBREAK: CN1.GNDBREAK
I2C_SCL: IC1.29 (PB10); also elsewhere on the board
I2C_SDA: IC1.55 (PB3); also elsewhere on the board
IF1-OUT: IF1.OUT, R122.2, R123.2
IF2-OUT: IF2.OUT, R125.2, R126.2
LED_HEARTBEAT: IC1.34 (PB13), R115.2
LTV+: D1.C, R100.1, U2.1 (ANODE)
LTV-: D1.A, MIDI.2, U2.2 (CATHODE)
MID_RX_IN: MIDI.1, R100.2
unnamed: LED1.A, R130.1
unnamed: R122.1, T2.B
unnamed: LED3.A, R146.1
unnamed: LED2.A, R138.1
unnamed: R149.1, RX1.A
unnamed: R150.1, RX2.A
unnamed: R126.1, T1.B
unnamed: R131.1, T9.C
unnamed: R141.1, T10.C
NRST: C111.1, IC1.7 (NRST), R116.1, RST.3, RST.4 (P1)
OH_SHIT_BTN: IC1.8 (PC0), OH_SHIT.1, R114.1
OLED_CS: IC1.20 (PA4), OLED.P6 (6)
OLED_DC: IC1.25 (PC5), OLED.P1 (1)
OLED_RST: IC1.24 (PC4), OLED.P2 (2)
R-HB: HEART.A, R115.1
RELAY: IC1.36 (PB15), R151.2
RELAY_OUT: Q2.1 (C), Q3.1 (C), RELAY_CTL.2
RLY_BASE: Q2.2 (B), Q3.2 (B), R151.1
ROT_CLK: IC1.2 (PC13), R120.1, ROTARY.P4 (4)
ROT_DAT: IC1.3 (PC14-OSC32_IN), R119.1, ROTARY.P3 (3)
ROT_SW: IC1.4 (PC15-OSC32_OUT), R118.1, ROTARY.P2 (2)
SDIO_CK: IC1.53 (PC12), J2.P5 (CLK)
SDIO_CMD: IC1.54 (PD2), J2.P3 (CMD), R106.1
SDIO_D0: IC1.39 (PC8), J2.P7 (DATA0), R110.1
SDIO_D1: IC1.40 (PC9), J2.P8 (DATA1), R109.1
SDIO_D2: IC1.51 (PC10), J2.P1 (DATA2), R108.1
SDIO_D3: IC1.52 (PC11), J2.P2 (DATA3/CD), R107.1
SDIO_DETECT: IC1.35 (PB14), J2.CD (DETECT), R111.1
SHIELD: J1.SH1 (SHIELD), J1.SH2 (SHIELD), J1.SH3 (SHIELD), J1.SH4 (SHIELD)
SPEAK1-R: R131.2, SPEAKER1.2
SPEAKER_EN: IC1.33 (PB12), R132.1, R142.1
SPI1_MISO: IC1.22 (PA6), OLED.P4 (4)
SPI1_MOSI: IC1.23 (PA7), OLED.P3 (3)
SPI1_SCK: IC1.21 (PA5), OLED.P5 (5)
SPK2_R: R141.2, SPEAKER2.2
SPKR_EN_BTN: IC1.27 (PB1), R117.1, SPKR_EN.1
SPK_EN1_B: R132.2, T9.B
SPK_EN2_B: R142.2, T10.B
SWCLK: IC1.49 (PA14), SWD.1
SWDIO: IC1.46 (PA13), SWD.2
TIM1_CH1: IC1.41 (PA8), R127.2, R128.2
TIM2_CH1: IC1.50 (PA15), R133.2, R134.1
TIM3_CH1: IC1.56 (PB4), R143.2, R144.2
TIM4_CH1: IC1.58 (PB6), R147.1, R148.2
TIM5_CH1: IC1.14 (PA0), R139.1, R140.2
TIM10_CH1: IC1.61 (PB8), R135.2, R136.2
UART1_RX: IC1.43 (PA10), R101.1, U2.4 (COLLECTOR)
UART1_TX: IC1.42 (PA9)
UART2_RX: IC1.17 (PA3), R121.1, R123.1, RX1.C, T2.C
UART2_TX: IC1.16 (PA2)
UART6_RX: IC1.38 (PC7), R124.1, R125.1, RX2.C, T1.C
UART6_TX: IC1.37 (PC6)
USBDN_CONN: D100.1 (I/O1_IN), J1.A7 (DN1), J1.B7 (DN2)
USBDP_CONN: D100.3 (I/O2_IN), J1.A6 (DP1), J1.B6 (DP2)
USBRESD_N: D100.6 (I/O1_OUT), R105.2
USBRESD_P: D100.4 (I/O2_OUT), R104.2
USB_D+: IC1.45 (PA12), R104.1
USB_D-: IC1.44 (PA11), R105.1
USB_VIN: CN1.PWR, D100.5 (VBUS), J1.A4_B9 (VBUS), J1.B4_A9 (VBUS), RELAY_CTL.3; also elsewhere on the board
VBAT_CONN: R112.2; also elsewhere on the board
XTAL1: C101.1, IC1.5 (PH0-OSC_IN), XTAL.1
XTAL2: C102.1, IC1.6 (PH1), XTAL.2

Notes on the sheet:
BRAINS
C29 = C30 = 2*(CL-Cstray)
IF-E96E: Vf=1.7 If=20mA DC
Voh = 2.9 Vol = 0.4
Same footprint as 47352-1001

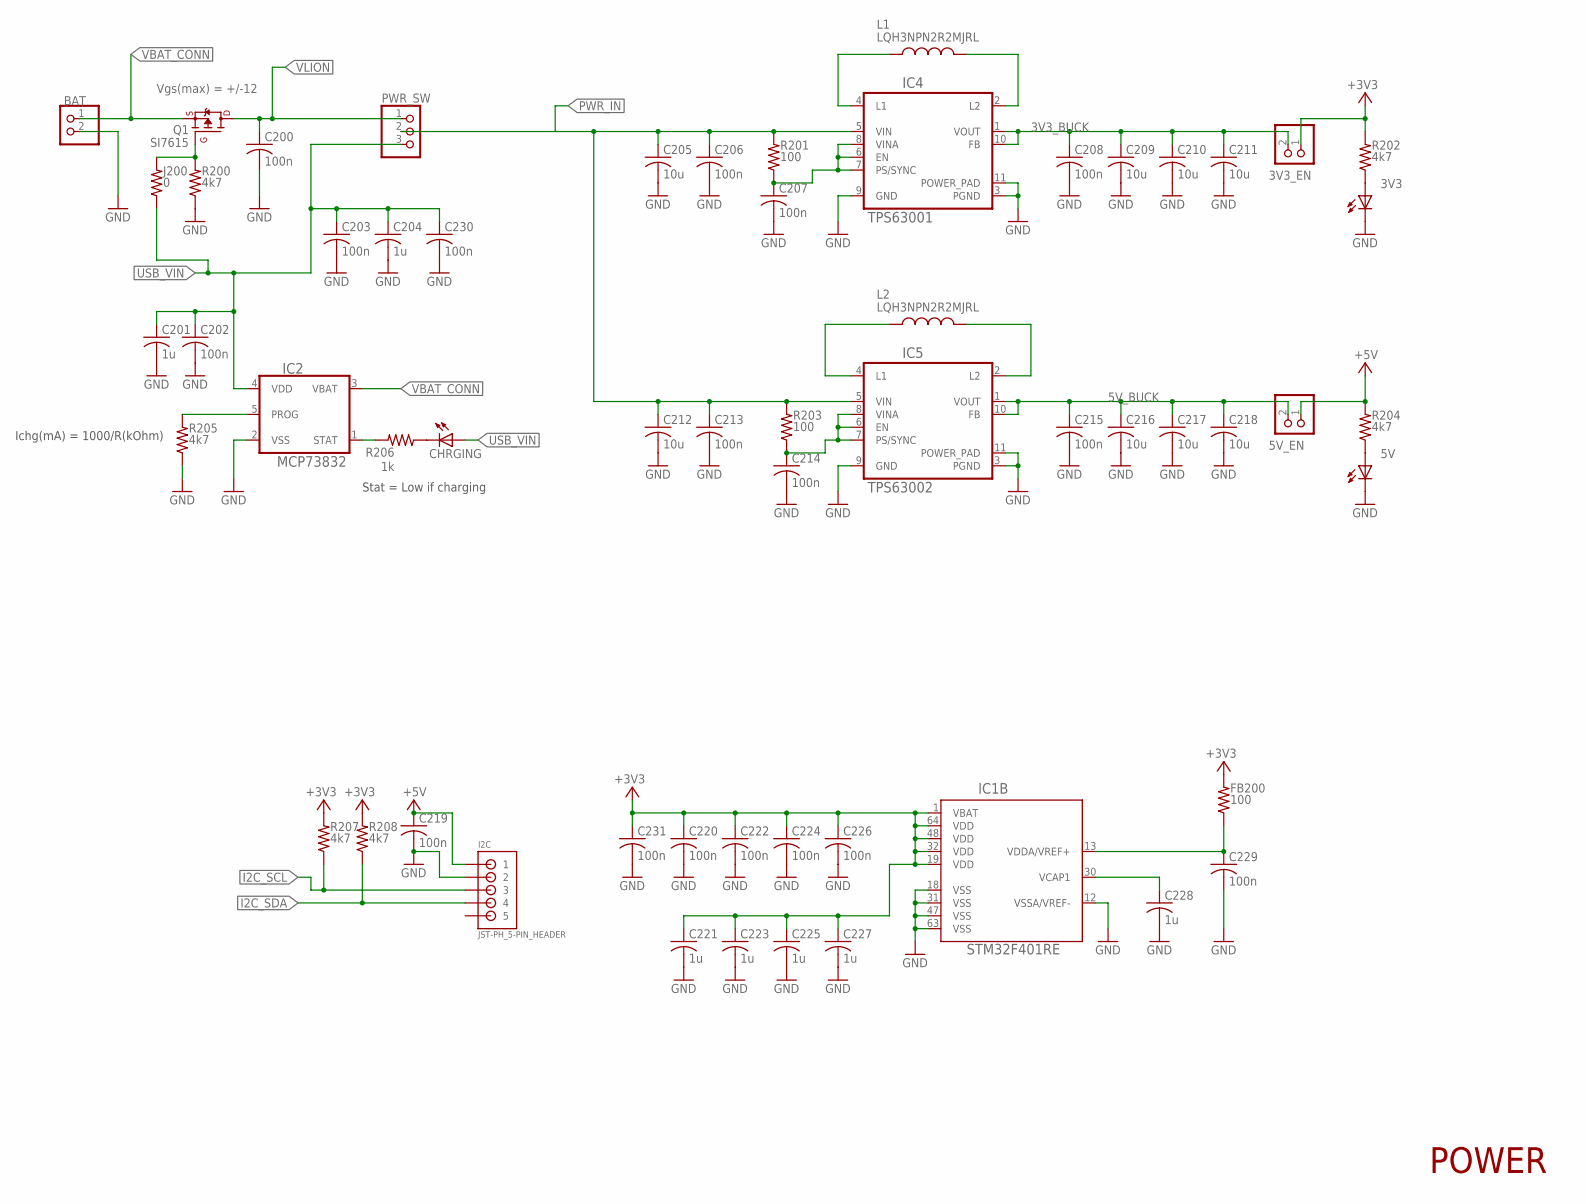
[picture p21: schematic revb.sch, sheet 2]

Parts:
3V3, 5V: LEDCHIPLED_0603; CHIPLED_0603
3V3_EN, 5V_EN: PINHD-1X2; 1X02
BAT: JST_2PIN-THM; JST-PH-2-THM
C200, C202, C203, C206, C207, C208, C213, C214, C215, C219, C220, C222, C224, C226, C229, C230, C231: 100n; C0603K
C201, C204, C221, C223, C225, C227, C228: 1u; C0603K
C205, C209, C210, C211, C212, C216, C217, C218: 10u; C0805
CHRGING: LEDCHIPLED_1206; CHIPLED_1206
FB200: 100; R0603
I2C: JST-PH_5-PIN_HEADER; JST_B5B-PH_HEADER
IC1: STM32F401RE; LQFP64-10X10MM
IC2: MCP73832; SOT95P280X145-5N
IC4: TPS63001; VREG_V62/16624-01YE
IC5: TPS63002; VREG_V62/16624-01YE
J200: 0; R0402
L1, L2: LQH3NPN2R2MJRL; IND_LQH3NPN2R2MJRL
PWR_SW: PINHD-1X3; 1X03
Q1: SI7615; VISHAY_SIS468DN-T1-GE3
R200, R202, R204, R205, R207, R208: 4k7; R0603
R201, R203: 100; R0603
R206: 1k; R0603

Connections:
3V3_BUCK: 3V3_EN.2, C208.1, C209.1, C210.1, C211.1, IC4.1 (VOUT), IC4.10 (FB)
5V_BUCK: 5V_EN.2, C215.1, C216.1, C217.1, C218.1, IC5.1 (VOUT), IC5.10 (FB)
+3V3: 3V3_EN.1, C220.1, C221.1, C222.1, C223.1, C224.1, C225.1, C226.1, C227.1, C231.1, FB200.2, IC1.1 (VBAT), IC1.19 (VDD), IC1.32 (VDD), IC1.48 (VDD), IC1.64 (VDD), R202.2, R207.2, R208.2; also elsewhere on the board
+5V: 5V_EN.1, C219.1, I2C.P1 (1), R204.2; also elsewhere on the board
BUCK33_LOGIC: C207.1, IC4.6 (EN), IC4.7 (PS/SYNC), IC4.8 (VINA), R201.1
BUCK50_LOGIC: C214.1, IC5.6 (EN), IC5.7 (PS/SYNC), IC5.8 (VINA), R203.1
CHG_PROG: IC2.5 (PROG), R205.2
CHRG_STAT: IC2.1 (STAT), R206.2
GND: 3V3.C, 5V.C, BAT.2 (1), C200.2, C201.2, C202.2, C203.2, C204.2, C205.2, C206.2, C207.2, C208.2, C209.2, C210.2, C211.2, C212.2, C213.2, C214.2, C215.2, C216.2, C217.2, C218.2, C219.2, C220.2, C221.2, C222.2, C223.2, C224.2, C225.2, C226.2, C227.2, C228.2, C229.2, C230.2, C231.2, I2C.P2 (2), IC1.12 (VSSA/VREF-), IC1.18 (VSS), IC1.31 (VSS), IC1.47 (VSS), IC1.63 (VSS), IC2.2 (VSS), IC4.3 (PGND), IC4.9 (GND), IC4.11 (POWER_PAD), IC5.3 (PGND), IC5.9 (GND), IC5.11 (POWER_PAD), R200.1, R205.1; also elsewhere on the board
I2C_SCL: I2C.P3 (3), R207.1; also elsewhere on the board
I2C_SDA: I2C.P4 (4), R208.1; also elsewhere on the board
IC4L1: IC4.4 (L1), L1.1
IC4L2: IC4.2 (L2), L1.2
IC5L1: IC5.4 (L1), L2.1
IC5L2: IC5.2 (L2), L2.2
unnamed: 3V3.A, R202.1
unnamed: 5V.A, R204.1
unnamed: CHRGING.C, R206.1
PMOS_G: J200.2, Q1.4 (G), R200.2
PWR_IN: C205.1, C206.1, C212.1, C213.1, IC4.5 (VIN), IC5.5 (VIN), PWR_SW.2, R201.2, R203.2
USB_VIN: C201.1, C202.1, C203.1, C204.1, C230.1, CHRGING.A, IC2.4 (VDD), J200.1, PWR_SW.3; also elsewhere on the board
VBAT_CONN: BAT.1 (2), IC2.3 (VBAT), Q1.1 (S), Q1.2 (S), Q1.3 (S); also elsewhere on the board
VCAP1: C228.1, IC1.30 (VCAP1)
VLION: C200.1, PWR_SW.1, Q1.5 (D), Q1.6 (D), Q1.7 (D), Q1.8 (D), Q1.9 (D)
VREF+: C229.1, FB200.1, IC1.13 (VDDA/VREF+)

Notes on the sheet:
POWER
Vgs(max) = +/-12
Stat = Low if charging
Ichg(mA) = 1000/R(kOhm)

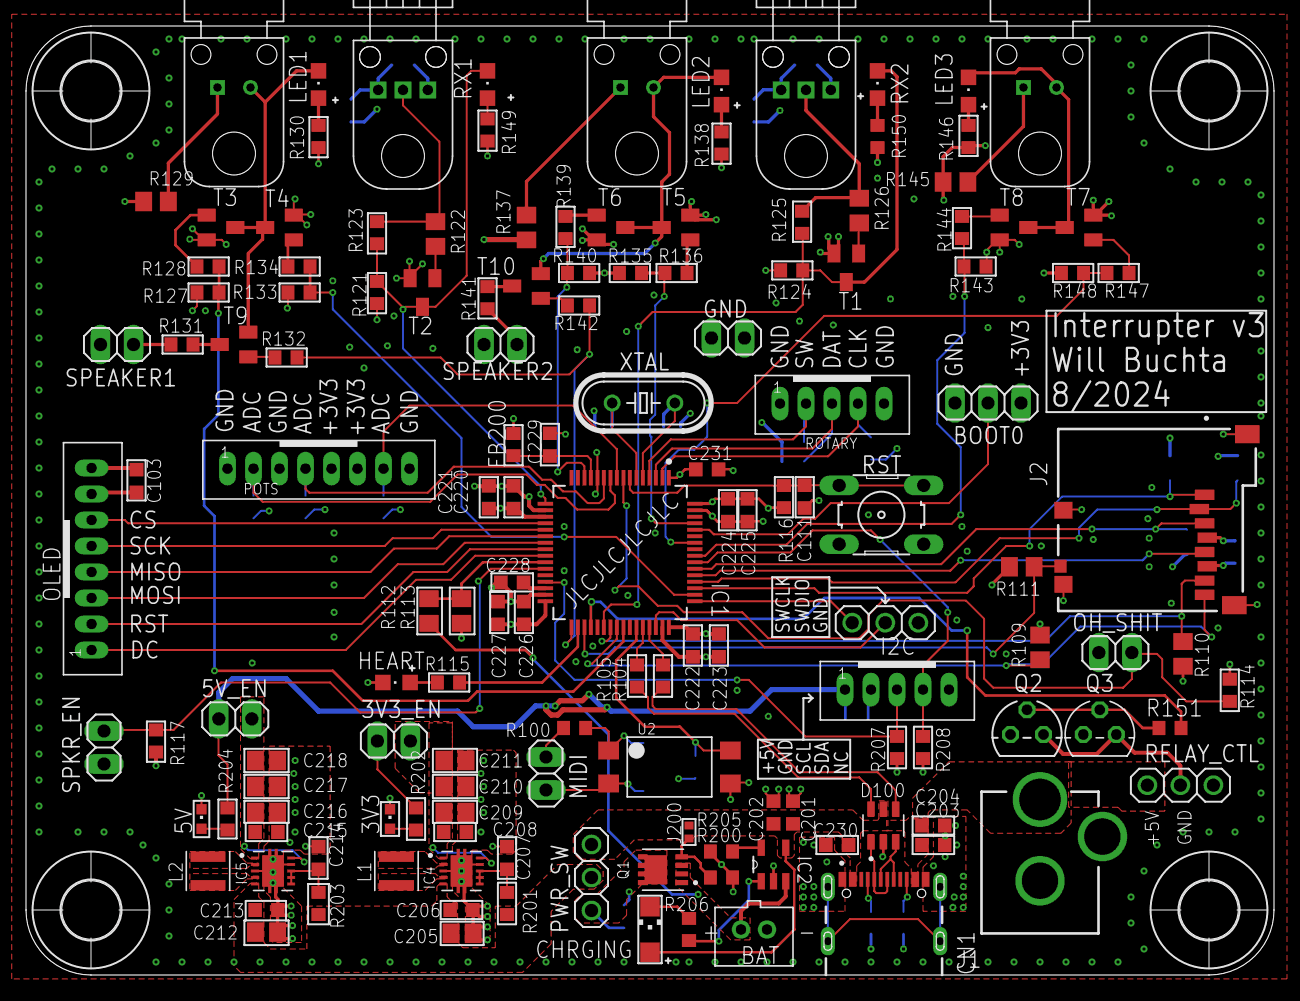
[picture p22: board revb.brd from above]

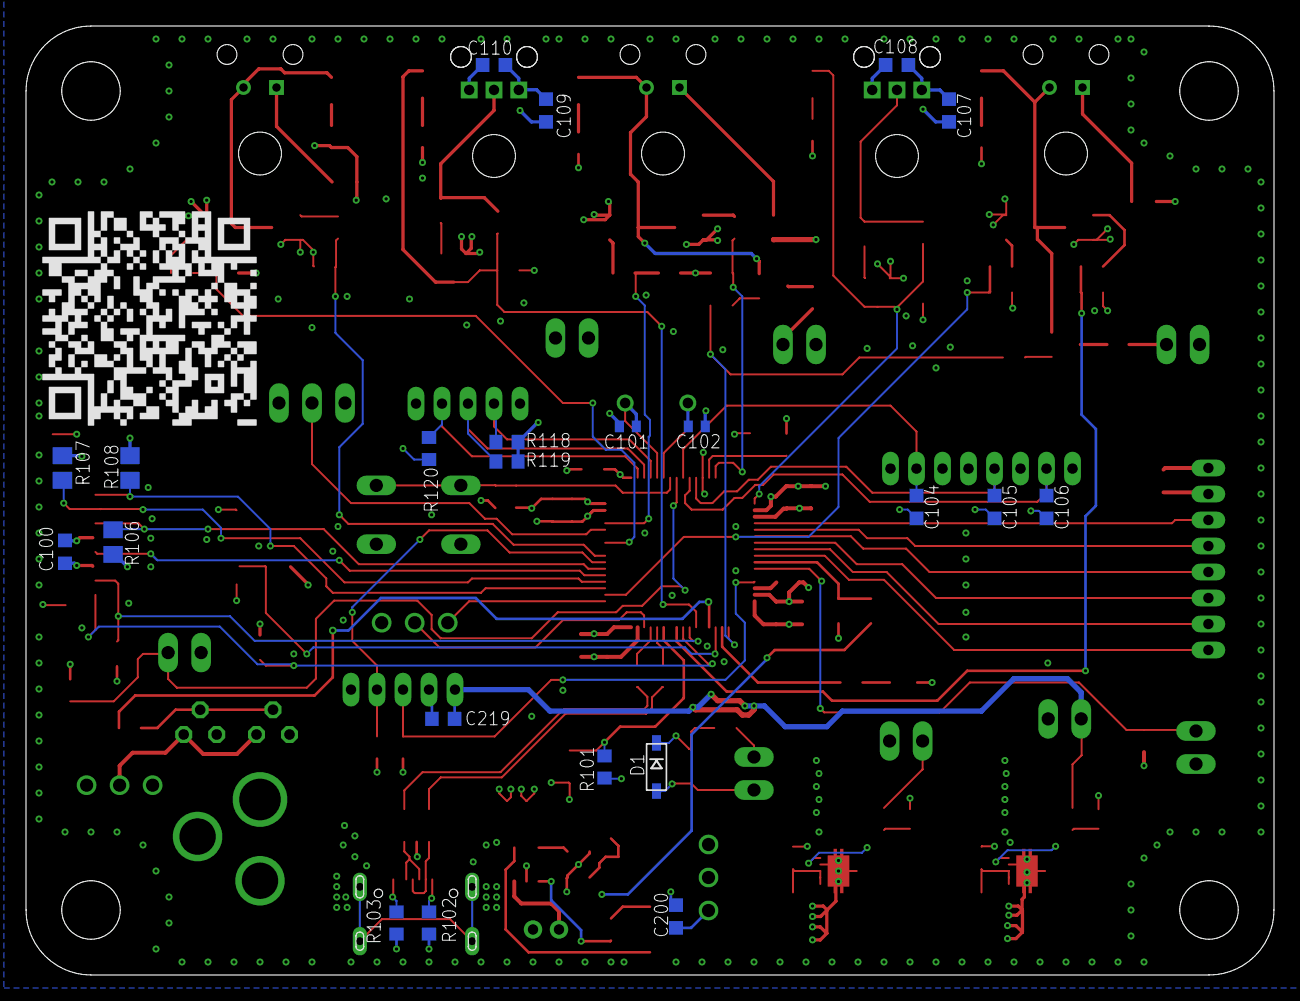
[picture p23: board revb.brd from below]

Board: 4 copper layers, 96.0 x 73.0 mm, 169 parts (22 on the bottom side), 107 nets.
