buchtawill/TeslaCoilController/Rev2_F401RE/cubeide_proj/Core/Src/main.c

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
/* Includes ------------------------------------------------------------------*/
#include "main.h"
#include "fatfs.h"

/* USER CODE BEGIN Includes */
#include "I2C_LCD.h"
#include "midi_keyboard_handler.h"
#include "stdio.h"
#include "timers.h"
#include "midi.h"

/* USER CODE END Includes */

ADC_HandleTypeDef hadc1;
DMA_HandleTypeDef hdma_adc1;

I2C_HandleTypeDef hi2c2;

SD_HandleTypeDef hsd;

SPI_HandleTypeDef hspi1;

TIM_HandleTypeDef htim1;
TIM_HandleTypeDef htim2;
TIM_HandleTypeDef htim5;
TIM_HandleTypeDef htim9;
TIM_HandleTypeDef htim10;
TIM_HandleTypeDef htim11;

UART_HandleTypeDef huart1;
UART_HandleTypeDef huart2;
UART_HandleTypeDef huart6;

/* USER CODE BEGIN PV */
FATFS     fs;
FIL       file;
FRESULT   fresult;
FILINFO   fno;
DIR       dir;
LCD       lcd;

uint16_t tx1_pulse_width = 1, prev_tx1_width = 0;
uint16_t tx2_pulse_width = 1, prev_tx2_width = 0;

volatile uint16_t adc_dma_results[4];
const int         adcChannelCount = sizeof(adc_dma_results) / sizeof(adc_dma_results[0]);
volatile uint8_t  adc_conv_complete = 0; //set by callback

/* USER CODE END PV */

void SystemClock_Config(void);
static void MX_GPIO_Init(void);
static void MX_DMA_Init(void);
static void MX_ADC1_Init(void);
static void MX_I2C2_Init(void);
static void MX_SDIO_SD_Init(void);
static void MX_TIM1_Init(void);
static void MX_TIM2_Init(void);
static void MX_USART1_UART_Init(void);
static void MX_USART2_UART_Init(void);
static void MX_USART6_UART_Init(void);
static void MX_SPI1_Init(void);
static void MX_TIM11_Init(void);
static void MX_TIM9_Init(void);
static void MX_TIM5_Init(void);
static void MX_TIM10_Init(void);
/* USER CODE BEGIN 0 */
// void toggle_speaker_en_pin(){
//   HAL_GPIO_TogglePin(SPKR_EN_GPIO_Port, SPKR_EN_Pin);
// }

/* USER CODE END 0 */

/**
  * @brief  The application entry point.
  * @retval int
  */
int main(void)
{
  /* MCU Configuration--------------------------------------------------------*/

  /* Reset of all peripherals, Initializes the Flash interface and the Systick. */
  HAL_Init();

  /* Configure the system clock */
  SystemClock_Config();

  /* Initialize all configured peripherals */
  MX_GPIO_Init();
  MX_DMA_Init();
  MX_ADC1_Init();
  MX_I2C2_Init();
  MX_SDIO_SD_Init();
  MX_TIM1_Init();
  MX_TIM2_Init();
  MX_USART1_UART_Init();
  MX_USART2_UART_Init();
  MX_USART6_UART_Init();
  MX_FATFS_Init();
  MX_SPI1_Init();
  MX_TIM11_Init();
  MX_TIM9_Init();
  MX_TIM5_Init();
  MX_TIM10_Init();
  /* Infinite loop */
  /* USER CODE BEGIN WHILE */

    /**
     * What we need to worry about for interrupter FW
     * 1.  USB messages from upstream source
     * 2.  Current player mode (Choose mode, SD mode, Fixed, Burst)
     * 3.  LCD status based on mode (Same as interrupter REV1) --> I2C2
     * 4.  PWM Timers (TIM1, TIM2, TIM3, TIM4, TIM5, TIM10)
     *                |-- Coil1 --|-- Coil2 --|-- Coil3 --|
     * 5.  General purpose timers (TIM9, TIM11: Millis)
     * 6.  Rotary encoder SW pin
     * 7.  Rotary encoder CLK interrupt and data pin
     * 8.  ADC for potentiometers and battery voltage
     * 9.  Oh shit button: stop all pwm
     * 10. UART RX from the coils (Coil1: USART2, Coil2: USART6)
     * 11. UART RX from MIDI (USART1)
     * 12. OLED screen (display stats about coils: battery voltage, temp, etc)
     * 13. SD Card I/O
     * 
     * Interrupts:
     * 1. Millis timer
     * 2. ADC callback
     * 3. External Int:
     *    ROT_CLK, ROT_SW, OH_SHIT_BTN, SPKR_EN_BTN
     */

  /**
   * What we need to worry about for the display case
   * Main loop: Boot into MODE_SELECT screen. Either MODE_KEYBOARD or MODE_SD. As soon as a mode is selected,
   *            flip the relay and turn the coil on.
   * 	If MODE_KEYBOARD, Display instructions and a timer. Timer starts counting when first note is played.
   * 	If SD mode, choose a song, play it, using piano keys as up/down keys
   *
   * 	After a song is done or live mode timer is done, go back to mode-select screen, display a DEAD_TIME_MIN minute timer and
   * 	a funny message
   *
   * 	If either of the above modes are chosen but nothing is subsequently done after 5 minutes, turn the relay off, go back to
   * 	MODE_SELECT, but with no DEAD_TIME_MIN minute wait
   *
   */

    //Initialize everything:
    // Start the timers
    // Initialize the LCD

  	// Millis counter
    init_timers();
  	HAL_TIM_Base_Start_IT(&MILLIS_TIMER_HANDLE);
    init_menu();
	HAL_Delay(1000);
  
	keyboard_start_rx_it();

	HAL_GPIO_WritePin(SPKR_EN_GPIO_Port, SPKR_EN_Pin, GPIO_PIN_SET);
	HAL_GPIO_WritePin(RELAY_GPIO_Port, RELAY_Pin, GPIO_PIN_RESET);

	// IF1 is TIM1 Ch1 and TIM2 Ch1
  // IF2 is TIM5 Ch1 and TIM10 Ch1
  setTimerFrequencyPulseWidth(&htim1, 0, 0, 0);
  setTimerFrequencyPulseWidth(&htim2, 0, 0, 0);
  setTimerFrequencyPulseWidth(&htim5, 0, 0, 0);
  setTimerFrequencyPulseWidth(&htim10, 0, 0, 0);
	HAL_TIM_PWM_Start(&htim1, TIM_CHANNEL_1);
	HAL_TIM_PWM_Start(&htim2, TIM_CHANNEL_1);
	HAL_TIM_PWM_Start(&htim5, TIM_CHANNEL_1);
	HAL_TIM_PWM_Start(&htim10, TIM_CHANNEL_1);

	// main loop will receive midi messages and handle them accordingly
	// If in choose mode, interpret midi messages as up/down/enter buttons
	// else actual music

	// 255 = not currently playing
	uint32_t led_start_time = 0;
	uint64_t t_cooldown_start = 0;
	uint64_t t_keyboard_start = 0;
  uint64_t prev_adc_time = 0;

	int64_t cooldown_ms_left = 0;
	int64_t keyboard_ms_left = 0;
	uint16_t cooldown_sec_left = 0;
	uint16_t keyboard_sec_left = 0;
	int64_t prev_cooldown_sec_left = 0;
	int64_t prev_keyboard_sec_left = 0;

	// Boot into cooldown state
	UCState top_state = S_PRE_COOLDOWN;

    while (1){

    	// Check for new midi messages
    	// Any state can access this midi message and interpret it how it wants
    	MidiMsg_t *p_msg = deq_next_midi_msg();
    	if(p_msg != NULL){
    		led_start_time = get_millis();
    		HAL_GPIO_WritePin(LED_HEARTBEAT_GPIO_Port, LED_HEARTBEAT_Pin, GPIO_PIN_SET);
    	}

		switch (top_state){
		case S_PRE_COOLDOWN:
			menu_start_cooldown_msg();
			t_cooldown_start = get_millis();
			top_state = S_COOLDOWN;
			break;
		////////////////////////////////////////////////////////////////////
		case S_COOLDOWN:
			cooldown_ms_left = 1000 - (get_millis() - t_cooldown_start);
			cooldown_sec_left = 1 + cooldown_ms_left / 1000;
			if(cooldown_sec_left != prev_cooldown_sec_left){
				prev_cooldown_sec_left = cooldown_sec_left;
				menu_update_cooldown_msg(cooldown_sec_left);
			}
			if(cooldown_ms_left <= 0){
				top_state = S_CHOOSE_MODE;
			}
			break;
		////////////////////////////////////////////////////////////////////
		case S_CHOOSE_MODE:
			top_state = S_PLAYING_KEYBOARD;
			menu_start_keyboard_msg();
			t_keyboard_start = get_millis();
			break;
		////////////////////////////////////////////////////////////////////
		case S_PLAYING_KEYBOARD:
//			keyboard_ms_left = 30000 - (get_millis() - t_keyboard_start);
//			keyboard_sec_left = 1 + keyboard_ms_left / 1000;
//			if(keyboard_sec_left != prev_keyboard_sec_left){
//				prev_keyboard_sec_left = keyboard_sec_left;
//				menu_update_keyboard_msg(keyboard_sec_left);
//			}

			if(p_msg != NULL){
				MidiMsg_t *next_stored_msg = handle_midi_output_msg(p_msg);
				while(next_stored_msg != NULL){
					next_stored_msg = handle_midi_output_msg(next_stored_msg);
				}
			}
//			if(keyboard_ms_left <= 0){
//				shutoff_all_notes();
//				top_state = S_PRE_COOLDOWN;
//			}
			break;
		////////////////////////////////////////////////////////////////////
		case S_CHOOSE_SD_SONG:
			break;
		////////////////////////////////////////////////////////////////////
		case S_PLAYING_SD_SONG:
			break;
		////////////////////////////////////////////////////////////////////
		default: break;

		} // switch(top_state)

    	// GPIO_PinState val = HAL_GPIO_ReadPin(SPKR_EN_BTN_GPIO_Port, SPKR_EN_BTN_Pin);

      // Turn it off 25 ms after receiving a UART message
    	if((get_millis() - led_start_time) > 25){
    		HAL_GPIO_WritePin(LED_HEARTBEAT_GPIO_Port, LED_HEARTBEAT_Pin, GPIO_PIN_RESET);
    	}

      // Start more ADC conversions
      if((get_millis() - prev_adc_time) > 50){
        prev_adc_time = get_millis();
        HAL_ADC_Stop_DMA(&hadc1);  // Stop the DMA to ensure it resets
        HAL_ADC_Start_DMA(&hadc1, (uint32_t*) adc_dma_results, adcChannelCount);
      }
      if(adc_conv_complete){
    	  adc_conv_complete = 0;
        
        prev_tx1_width = tx1_pulse_width;
        prev_tx2_width = tx2_pulse_width;
    	  // 0-127
    	  tx1_pulse_width = adc_dma_results[1] >> 1;
    	  tx2_pulse_width = adc_dma_results[1] >> 1;

        if(tx1_pulse_width != prev_tx1_width)menu_print_on_time(tx1_pulse_width);
      }


        // Test if the relay works
//    	static uint64_t relay_time = 0;
//    	if((get_millis() - relay_time) > 1000){
//    		relay_time = get_millis();
//    		HAL_GPIO_TogglePin(RELAY_GPIO_Port, RELAY_Pin);
//    	}

    /* USER CODE END WHILE */

    /* USER CODE BEGIN 3 */
    }
  /* USER CODE END 3 */
}

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
/* USER CODE BEGIN 4 */

// Needs to be defined in main because (eventually) there will be other UARTs in use
void HAL_UART_RxCpltCallback(UART_HandleTypeDef *huart){
	if(huart == &KEYBOARD_UART_HANDLE) {
		handle_keyboard_rx_it();
        keyboard_start_rx_it();
    }
}

void HAL_ADC_ConvCpltCallback(ADC_HandleTypeDef *hadc) {
	adc_conv_complete = 1;
}

/**
 * @brief  EXTI line detection callbacks.
 * @param  GPIO_Pin Specifies the port pin connected to corresponding EXTI line.
 * @retval None
 */
void HAL_GPIO_EXTI_Callback(uint16_t GPIO_Pin) {
	switch(GPIO_Pin){
        case ROT_CLK_Pin:     break;

        case ROT_SW_Pin:      break;

        case OH_SHIT_BTN_Pin: break;

        case SPKR_EN_BTN_Pin: break;

        default: break;
    }
}

/**
 * @brief ISR for timer interrupts
 * @param htim TIM_HandleTypeDef
 * @return None
 */
void HAL_TIM_PeriodElapsedCallback(TIM_HandleTypeDef *htim) {

    //Millis
	if (htim == &MILLIS_TIMER_HANDLE) {
		inc_millis();
	}

}

/* USER CODE END 4 */
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
