buchtawill/TeslaCoilController/Rev2_F401RE/cubeide_proj/Core/Inc/main.h

#define ROT_CLK_Pin GPIO_PIN_13
#define ROT_CLK_GPIO_Port GPIOC
#define ROT_CLK_EXTI_IRQn EXTI15_10_IRQn
#define ROT_DAT_Pin GPIO_PIN_14
#define ROT_DAT_GPIO_Port GPIOC
#define ROT_SW_Pin GPIO_PIN_15
#define ROT_SW_GPIO_Port GPIOC
#define ROT_SW_EXTI_IRQn EXTI15_10_IRQn
#define OH_SHIT_BTN_Pin GPIO_PIN_0
#define OH_SHIT_BTN_GPIO_Port GPIOC
#define OH_SHIT_BTN_EXTI_IRQn EXTI0_IRQn
#define OLED_CS_Pin GPIO_PIN_4
#define OLED_CS_GPIO_Port GPIOA
#define OLED_RST_Pin GPIO_PIN_4
#define OLED_RST_GPIO_Port GPIOC
#define OLED_DC_Pin GPIO_PIN_5
#define OLED_DC_GPIO_Port GPIOC
#define SPKR_EN_BTN_Pin GPIO_PIN_1
#define SPKR_EN_BTN_GPIO_Port GPIOB
#define SPKR_EN_BTN_EXTI_IRQn EXTI1_IRQn
#define SPKR_EN_Pin GPIO_PIN_12
#define SPKR_EN_GPIO_Port GPIOB
#define LED_HEARTBEAT_Pin GPIO_PIN_13
#define LED_HEARTBEAT_GPIO_Port GPIOB
#define SDIO_DETECT_Pin GPIO_PIN_14
#define SDIO_DETECT_GPIO_Port GPIOB
#define RELAY_Pin GPIO_PIN_15
#define RELAY_GPIO_Port GPIOB
#define INTERRUPTER_MODE_CHOOSE   0 //Choose the interrupter mode
#define INTERRUPTER_MODE_SD       1 //SD mode
#define INTERRUPTER_MODE_LIVE     2 //Live mode
#define INTERRUPTER_MODE_BURST    3 //Burst mode
#define INTERRUPTER_MODE_FIXED    4 //Fixed mode
#define INTERRUPTER_NUM_MODES     5
#define BURST_CHANGE_FREQ         0
#define BURST_CHANGE_TON          1
#define BURST_CHANGE_TOFF         2
#define BURST_PLAY_PAUSE          3
#define BURST_GO_BACK             4
#define BURST_NUM_STATES          5
#define FIXED_CHANGE_FREQ         0
#define FIXED_PLAY_PAUSE          1
#define FIXED_GO_BACK             2
#define FIXED_NUM_STATES          3
#define HUNDRED_DIGIT             0
#define TEN_DIGIT                 1
#define ONES_DIGIT                2
#define MAX_ROW_LCD  		4
#define MAX_CHAR_ON_SCREEN 	19 // Maximum number of characters the display can show
#define MAX_NUM_FILES    	32
#define MAX_FILENAME_LENGTH 64
#define KEYBOARD_UART_HANDLE huart1
#define MILLIS_TIMER_HANDLE  htim11
