buchtawill/TeslaCoilController/L151_interrupter/Core/Inc/main.h

#define stat595_SER_Pin GPIO_PIN_13
#define stat595_SER_GPIO_Port GPIOC
#define Pot1_Pin GPIO_PIN_0
#define Pot1_GPIO_Port GPIOA
#define Pot2_Pin GPIO_PIN_2
#define Pot2_GPIO_Port GPIOA
#define stat595_SCK_Pin GPIO_PIN_4
#define stat595_SCK_GPIO_Port GPIOA
#define LED_Heartbeat_Pin GPIO_PIN_0
#define LED_Heartbeat_GPIO_Port GPIOB
#define Flash__wp_Pin GPIO_PIN_1
#define Flash__wp_GPIO_Port GPIOB
#define Flash__Hold_Pin GPIO_PIN_2
#define Flash__Hold_GPIO_Port GPIOB
#define SPI2_SS_Pin GPIO_PIN_12
#define SPI2_SS_GPIO_Port GPIOB
#define ROT_BUT_Pin GPIO_PIN_8
#define ROT_BUT_GPIO_Port GPIOA
#define ROT_BUT_EXTI_IRQn EXTI9_5_IRQn
#define ROT_CLK_Pin GPIO_PIN_9
#define ROT_CLK_GPIO_Port GPIOA
#define ROT_CLK_EXTI_IRQn EXTI9_5_IRQn
#define ROT_DAT_Pin GPIO_PIN_10
#define ROT_DAT_GPIO_Port GPIOA
#define SD_CS_Pin GPIO_PIN_15
#define SD_CS_GPIO_Port GPIOA
#define boolean uint8_t
#define true  	1
#define false 	0
#define COIL1 	htim2
#define COIL2 	htim9
#define COIL3 	htim3
#define COIL4 	htim4
#define COIL5 	htim10
#define COIL1_CH TIM_CHANNEL_1
#define COIL2_CH TIM_CHANNEL_2
#define COIL3_CH TIM_CHANNEL_1
#define COIL4_CH TIM_CHANNEL_1
#define COIL5_CH TIM_CHANNEL_1
#define SD_GET_FIRST	0
#define SD_FETCH_NEXT	1
#define SD_WAIT_NEXT	3
#define SD_READ_ERR		4
#define SD_SPI_HANDLE 	hspi1
#define MODE_SELECT 0 //SD Card, Burst, or Fixed
#define SD_MODE 1
#define BURST_MODE 2
#define FIXED_MODE 3
#define MODE_NUM 3
#define B_FREQUENCY 	0
#define B_TON 			1
#define B_TOFF 			2
#define B_PLAY_PAUSE 	3
#define B_BACK 			4
#define BURST_STATE_NUM 4
#define F_FREQUENCY 	0
#define F_PLAY_PAUSE 	1
#define F_BACK 			2
#define FIXED_STATE_NUM 2
#define HUNDRED_DIGIT 0
#define TEN_DIGIT 1
#define SINGLE_DIGIT 2
#define MAX_ROW 			4
#define MAX_CHAR_ON_SCREEN 	19 // Maximum number of characters the display can show
#define MAX_NUM_FILES    	32
#define MAX_FILENAME_LENGTH 64
#define FREQ_DISP_POS 	6
#define T_ON_DISP_POS 	6
#define T_OFF_DISP_POS 	7
