buchtawill/TeslaCoilController/(commit log)

2023-10-21 Fix bugs and pray
    [I2C_LCD.c, main.c]
2023-10-21 Make Timers.c faster
2023-10-22 Fix bugs and increase efficiency
    [main.c]
2023-10-22 Fix scroll on SD Mode
    [main.c]
2024-07-26 Initial commit for L433 interrupter
2024-07-26 Add L151 board files
    [interrupter-reva.brd, interrupter-reva.sch]
2024-08-04 Remove L433 interrupter (Use F401RE)
2024-08-10 Add Eagle files
    [revb.brd, revb.sch]
2024-08-10 Remove Vsrc pin
2024-08-11 Add interrupts
2024-08-20 Initial upload
    [revb_BOM.csv]
2024-10-13 Print ontime twice
2024-10-13 Enable ADC CH2
2024-10-14 Create BOM
    [revb_BOM.xlsx, revb_BOM_assembly.xlsx]
2024-10-14 Add DMA
2024-10-14 DMA only started in while loop
2024-10-14 ***WORKING*** Implement two channel ADC capture with DMA, coordinate channel volume
2024-10-25 Finish first bringup task: display on all LEDs
2024-10-26 working Thermo Couple code. Tested in debugger. Not calibrated to a specific temperature source but temperature trend is consistent with external variables
2024-10-30 Make prototype of application. Bug: Left display does not work
    [display_board.ioc, main.c, main.h, sensor_board_f105.ioc, seven_seg.c, seven_seg.h]
2025-02-24 Add barrel jack, add headers, add jumper between buck and rail, fix OLED pinout
    [revb.brd, revb.sch]
2025-02-24 Save case state
2025-02-25 Add IO for a relay board
    [revb.brd, revb.sch, revb_BOM_assembly.xlsx, revb_pnp.xlsx]
2025-02-25 Submit to JLC for assembly
    [revb_BOM.xlsx, revb_BOM_assembly.xlsx, revb_pnp.xlsx]
2025-03-03 Add oneTesla interrupter FW
2025-04-04 Create new board for interactive case
2025-08-04 Remove USB drivers
2025-08-04 Sync workspace [final]
    [interrupter-reva.brd, interrupter-reva.sch, revb_BOM.csv, revb_BOM.xlsx]
2025-08-08 Implement UART receive and timer programming
2025-08-08 Stop PWM glitches at boot
    [F401RE_interrupter.ioc, main.c]
2025-08-14 Update timers to force-update timer after programming
2025-08-15 Implement basic state machine for LCD and interrupter state
2025-08-16 Move main and menu to C++, implement pitch bend, add extern c guards
2025-11-18 Move to EDA folder
    [main_board.brd, main_board.sch, reva.brd, reva.sch]
2025-12-05 Add ADC support
