buchtawill/TeslaCoilController/(notices)

Notices in the files:
Rev2_F401RE/cubeide_proj/Core/Inc/main.h:
Copyright (c) 2024 STMicroelectronics.
All rights reserved.
This software is licensed under terms that can be found in the LICENSE file
L151_interrupter/Core/Inc/main.h:
Copyright (c) 2022 STMicroelectronics.
parts and their libraries:
temp_sens_proj: COPYRIGHT: Copyright (C) 2023 Ultra Librarian. All rights reserved.
COPYRIGHT: Copyright (C) 2022 Ultra Librarian. All rights reserved.
COPYRIGHT: Copyright (C) 2024 Ultra Librarian. All rights reserved.
